tinytronix/homeautomation/Hardware/readme.md

Home automation hardware modules.
For all modules the gerber files are available.
The gerber files are proven in use and can be uploaded "as is" to any pcb manufacturer<br>

### The DIN rail housings (auf deutsch: Hutschienengehäuse) are available here:
https://www.reichelt.de/leergehaeuse-71-x-105-x-90-mm-6-te-hut-6-c-p44868.html<br>
https://www.reichelt.de/leergehaeuse-71-x-71-x-90-mm-4-te-hut-4-c-p44867.html?&trstct=pos_0<br>
OEM: https://www.h-tronic.de <br>

### Connector clamps:
AKL 073-03 Fahrstuhlklemme, 3-pol<br>
AKL 073-02 Fahrstuhlklemme, 2-pol<br>
https://www.reichelt.de<br>

### Other parts
see [part list](https://github.com/tinytronix/homeautomation/blob/master/Hardware/partlist.csv)
