tinytronix/homeautomation/Photos/readme.md

Controller Module:
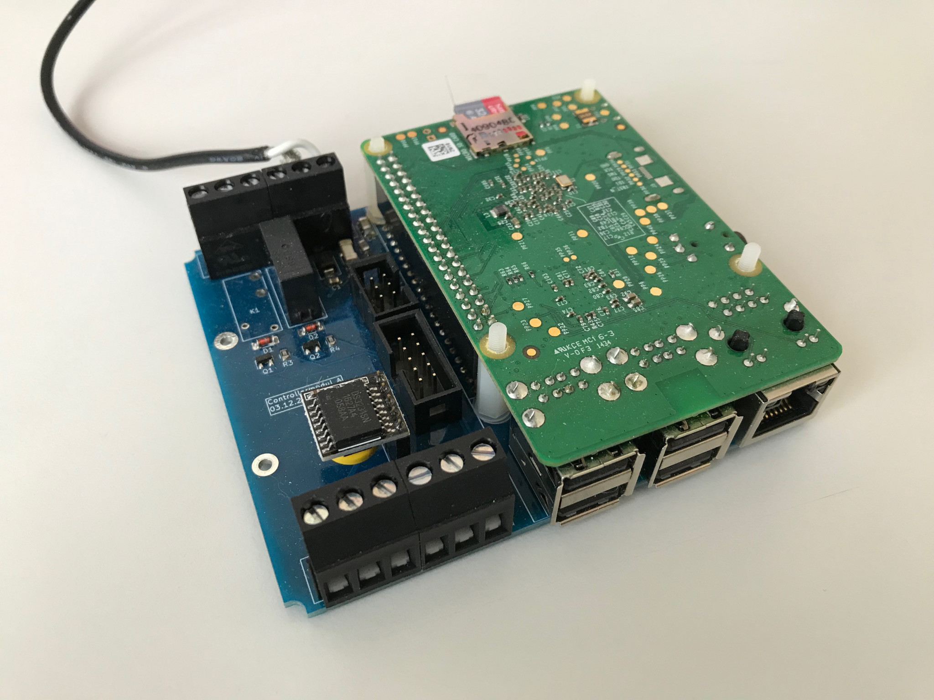
[picture p3: Photos/Controller_TypA.JPG]

<br>Modules open:
lt
<br>ESP07 (ESP8266) Controller Module:
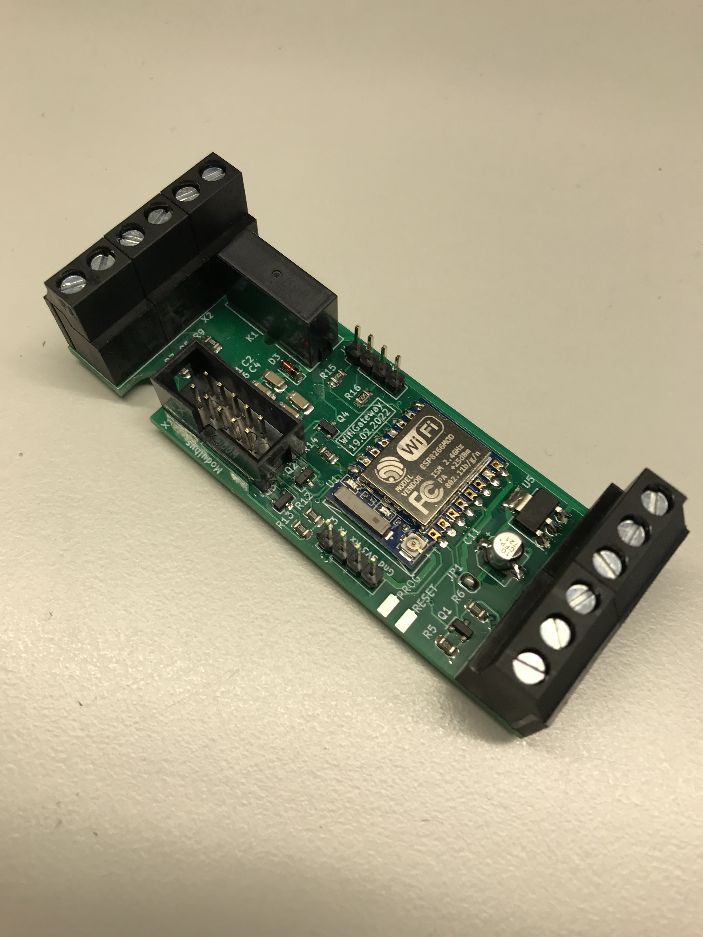
[picture p4: Photos/ESP07.jpg]

<br>ATMega328 Controller Module with ethernet:
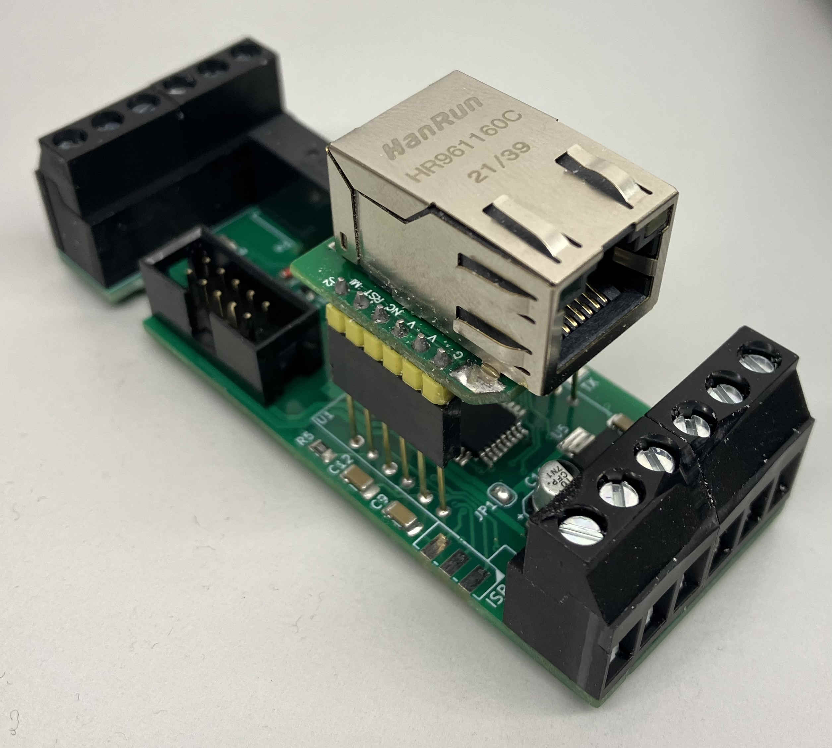
[picture p5: Photos/ControllerC1.jpg]

<br>ATMega328 Controller Module with ethernet with housing:
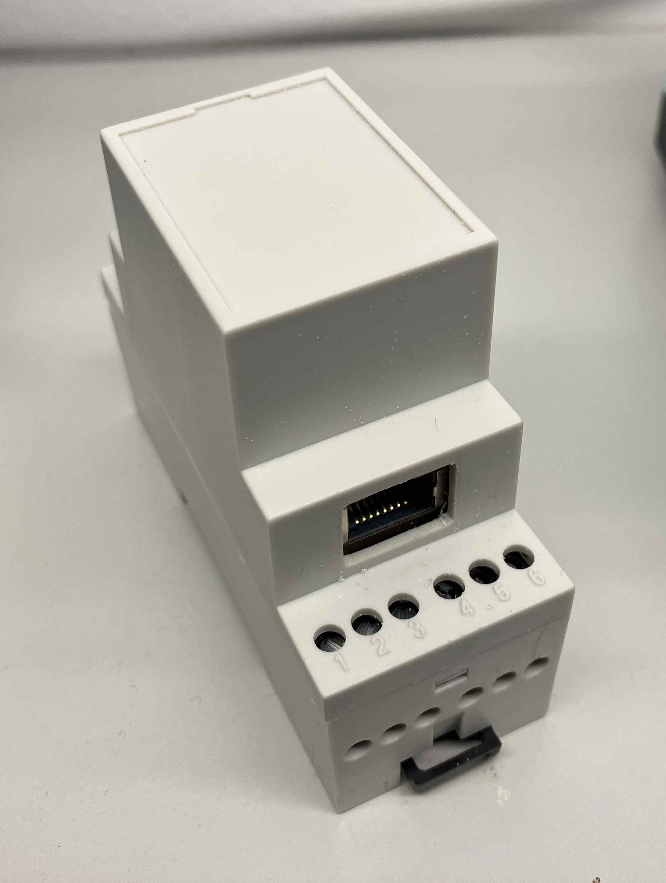
[picture p6: Photos/ControllerC3.jpg]

<br>Analog module:
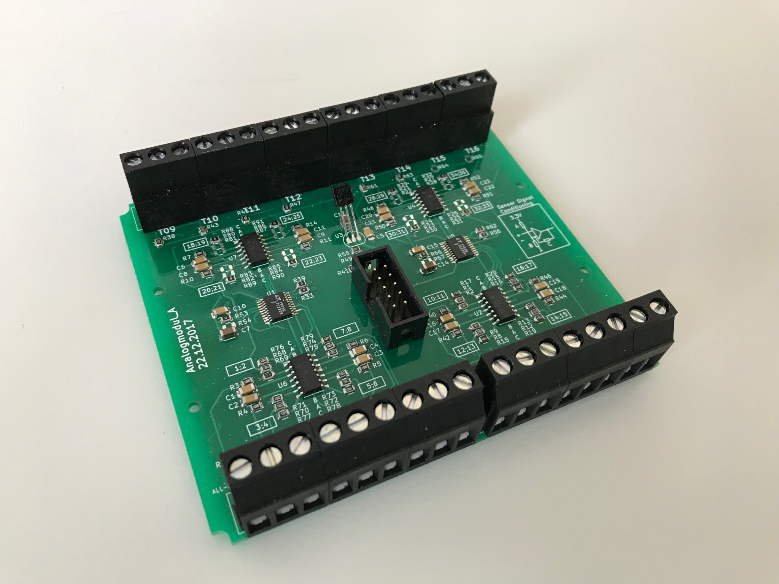
[picture p7: Photos/Analogmodul_TypA.JPG]

<br>Switching module Type A
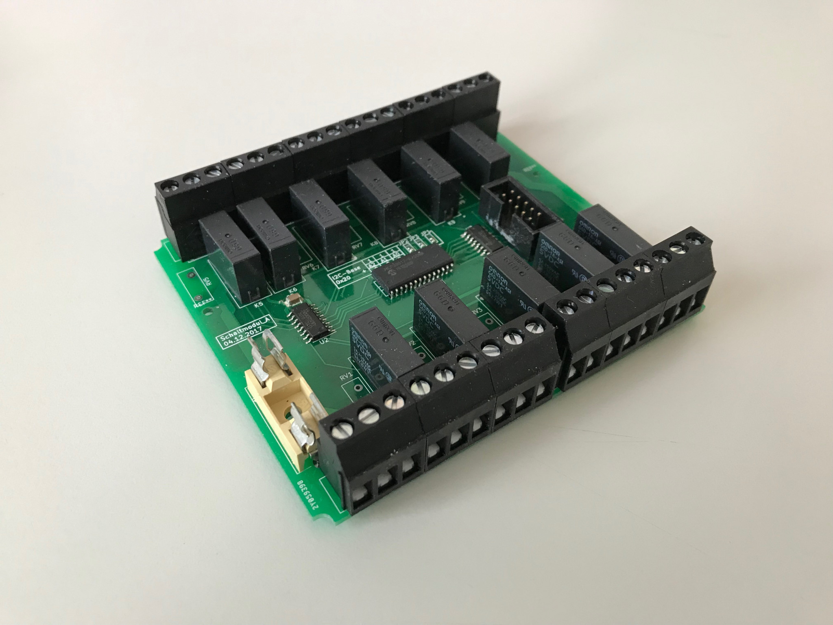
[picture p8: Photos/Schaltmodul_A.JPG]

<br>Inwall LoRa shutter module top view
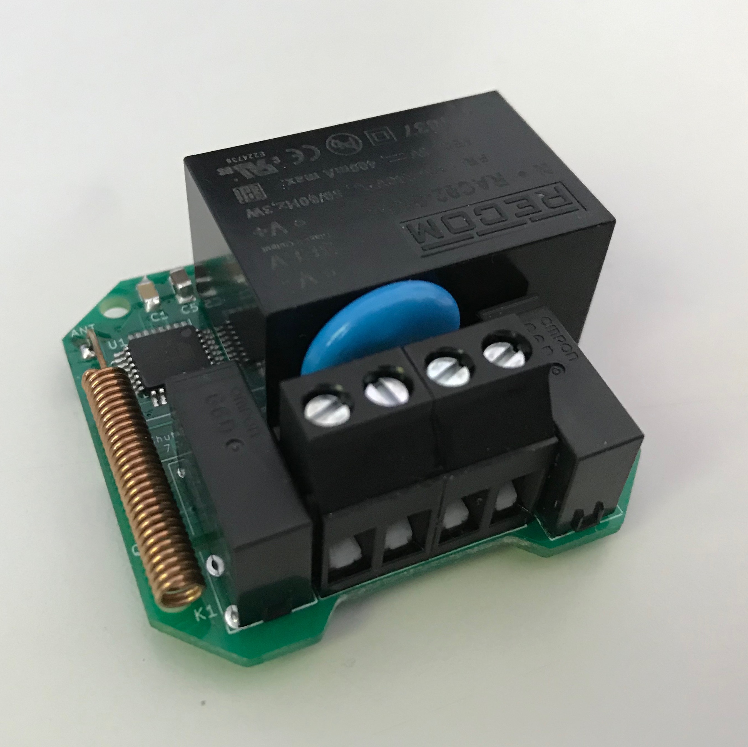
[picture p9: Photos/loraShutterModuleTop.JPG]

<br>Inwall LoRa shutter module bottom view
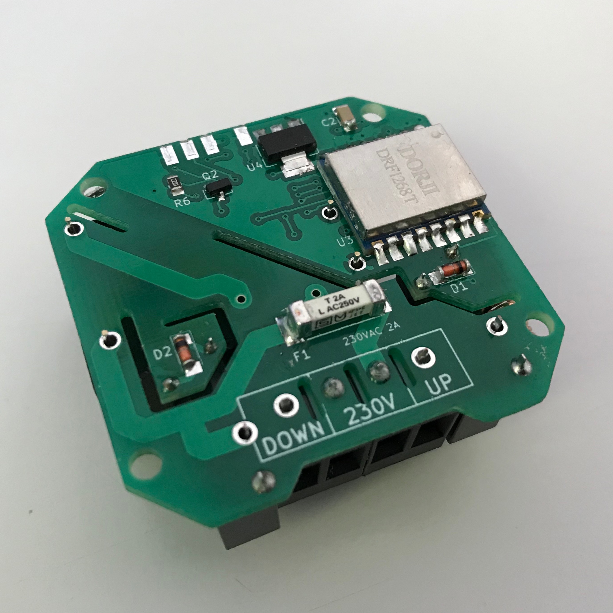
[picture p10: Photos/loraShutterModuleBottom.JPG]

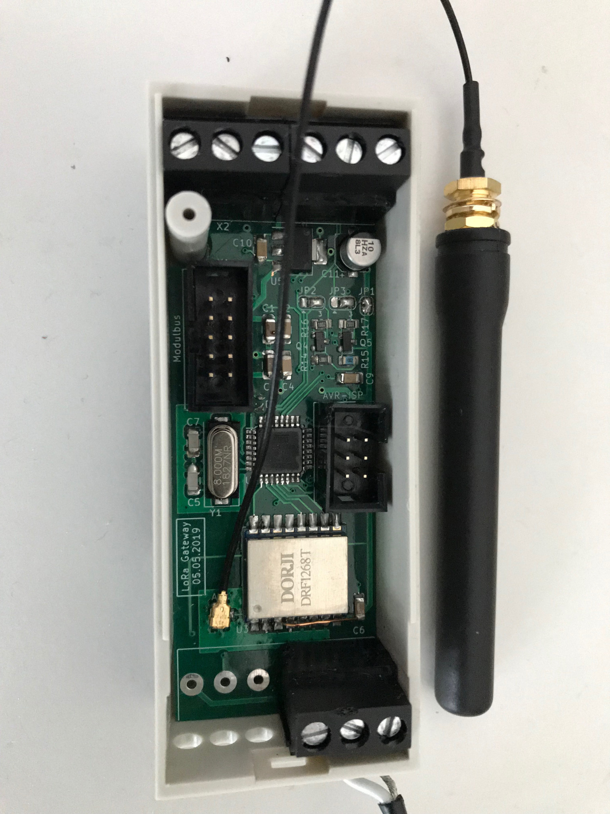
[picture p11: Photos/LoRa2.JPG]

<br>LoRa Wall plug
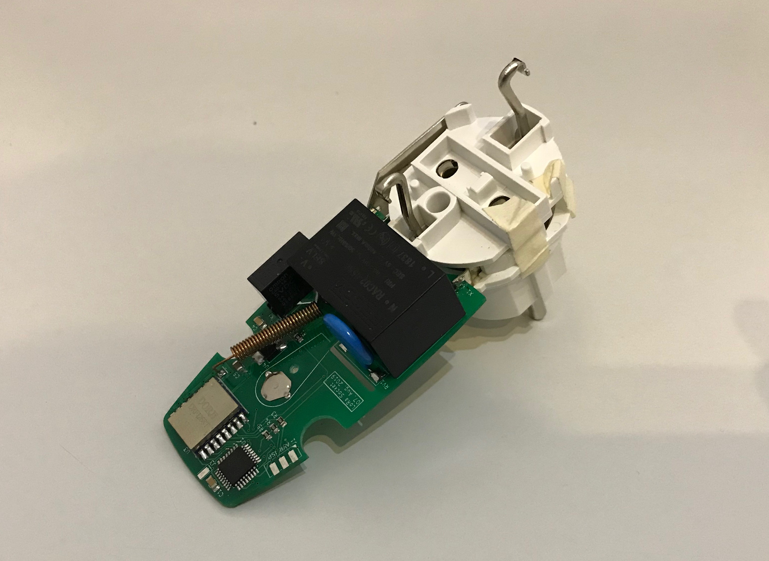
[picture p12: Photos/loraSteckdoseInnen.JPG]

<br>LoRa Wall plug mounted
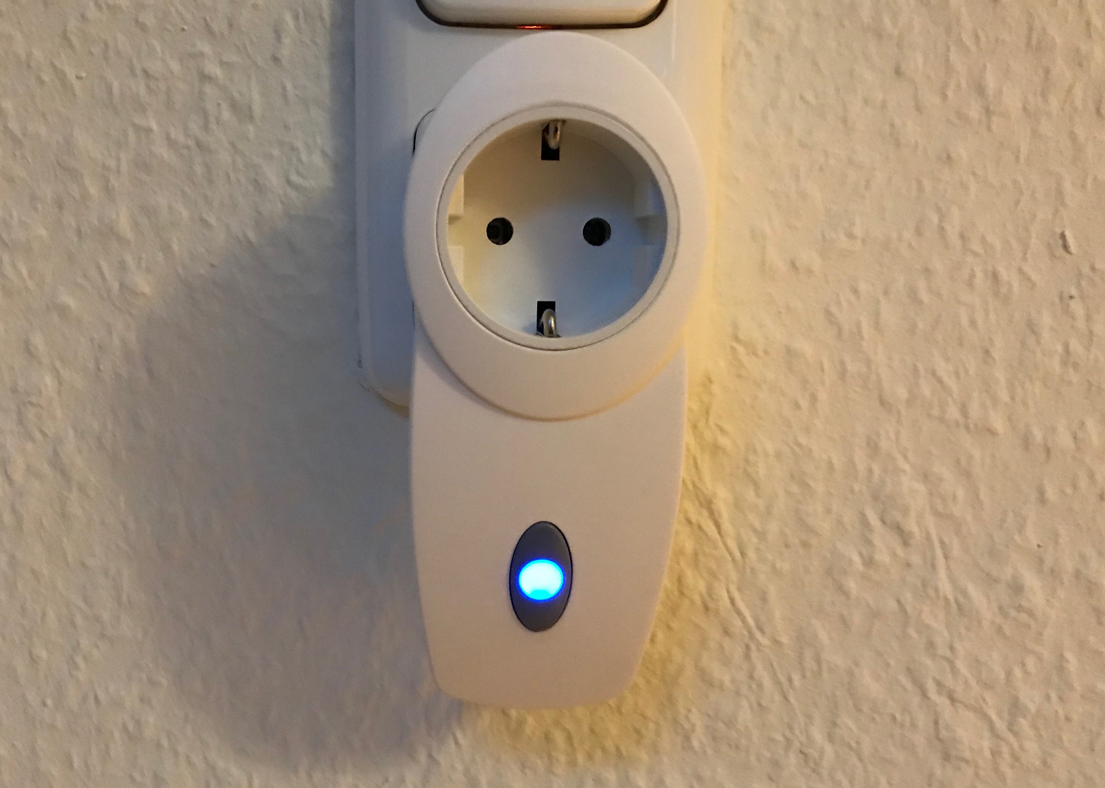
[picture p13: Photos/loraSteckdose.JPG]

<br>I2C Module Bus connector
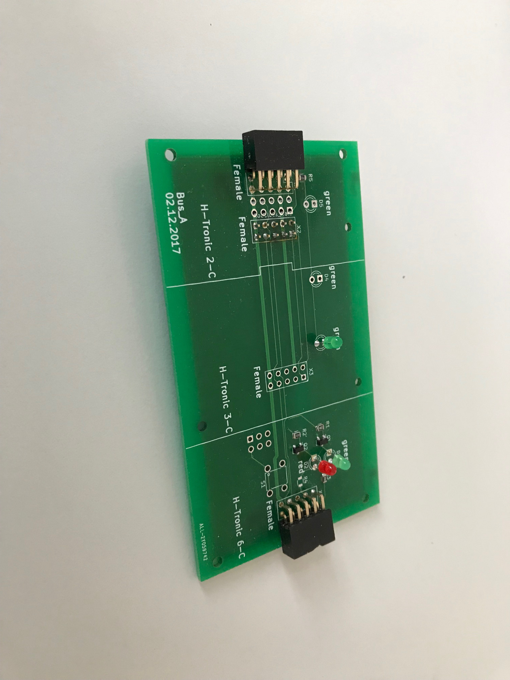
[picture p14: Photos/I2CBus.JPG]

<br>I2C Module Bus connector
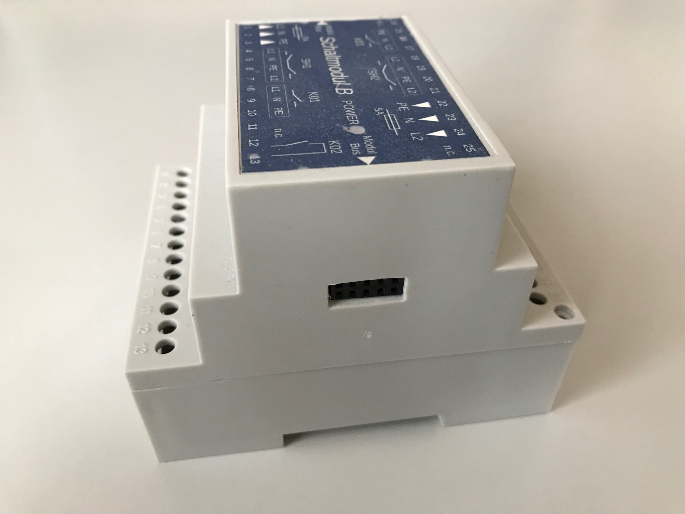
[picture p15: Photos/I2CConnector.JPG]
