tinytronix/homeautomation/Photos/README.md

lt

Analogmodul Typ A:
lt

Controller with Raspberry:
lt

Digital input Module Typ A for mains detection:
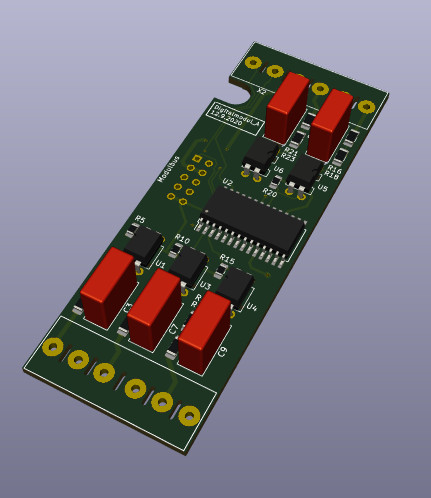
[picture p16: Photos/Digitalmodul_A.JPG]


LoRa Gateway or Bridge Module
lt

Switching Module Typ A
lt

LoRa Inwall SHutter Module
lt

LoRa switched Power Outlet
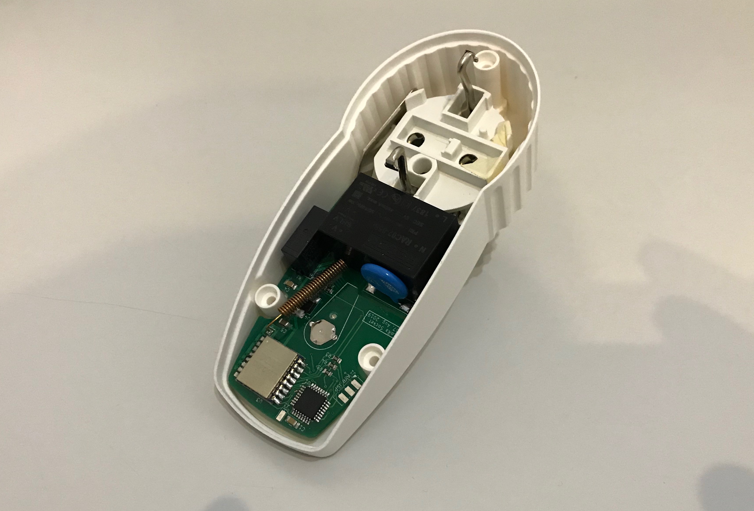
[picture p17: Photos/loraSteckdoseUnterteil.JPG]
