tinytronix/homeautomation/Hardware/Schaltmodul_C/readme.md

This module is a derivate of Schaltmodul_A and Schaltmodul_B.
It is optimised for garden irrigation purposes and can switch 16 channels.
