tinytronix/homeautomation/Hardware/Digitalmodul_A/readme.md

This module can read mains status (5 channels) and has one logic counter input 5V logic level.
