tinytronix/homeautomation/Hardware/LoraPowerswitch/readme.md

This LoRa node module is for switching 230V/2A on/off. 

Parameters:
- DRF1268 LoRa Module
- ATMega328 with internal 8MHz oscillator
- fits in a standard housing which can be sourced from [ELV Artnr. 68-08 34 21](https://www.elv.de/elv-design-stecker-steckdosen-gehaeuse-om-54-c-mit-tasterstoessel-und-led-leuchtfeld.html) 
- Atmel ISP interface and a serial tx connector at the pcb edge
- requires bootloader as explained here: https://www.arduino.cc/en/Tutorial/ArduinoToBreadboard
- remote controlled by the [Lora Gateway](https://github.com/tinytronix/homeautomation/tree/master/Hardware/LoraGateway)

Complete device:
lt
open:
lt
PCB only:
lt
