tinytronix/homeautomation/Hardware/LoraInwallShutter/readme.md

This LoRa node module is for driving window shutters or window blinds. (pulse up and pulse down). It can as well be used for switching lights or wall power outlets (permanent on/off).<br>
Parameters:
- DRF1268 LoRa Module
- ATMega328 with internal 8MHz oscillator
- fits in a 57mm diameter inwall housing <br>
- Height is 22mm
- extra deep inwall housings needed when placed behind wall switch/wall power outlet
- Atmel ISP interface and 
- a serial tx connector at the pcb edge.
- requires bootloader as explained here: https://www.arduino.cc/en/Tutorial/ArduinoToBreadboard
- remote controlled by the [Lora Gateway](https://github.com/tinytronix/homeautomation/tree/master/Hardware/LoraGateway)

Top view:
lt
Bottom view:
lt
