tinytronix/homeautomation/Hardware/Schaltmodul_A/readme.md

This module contains 11 Relais, 230V AC, 5A
