tinytronix/homeautomation/Hardware/Analogmodul_A/readme.md

This module contains 16 Analog inputs with 16 Rail-2-Rail OP-Amps for signal conditioning. 
The module can be connected to a controller module which reads the analog inputs.
