tinytronix/homeautomation/Photos/ControllerC2.jpg

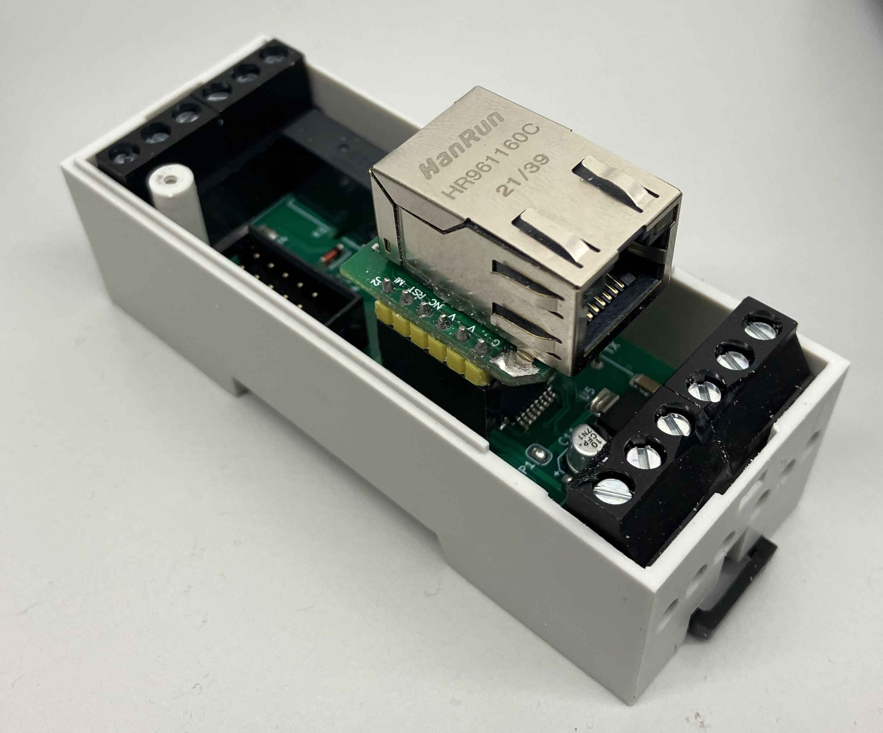
Photos/ControllerC2.jpg
