tinytronix/homeautomation/Photos/LoRa1.JPG

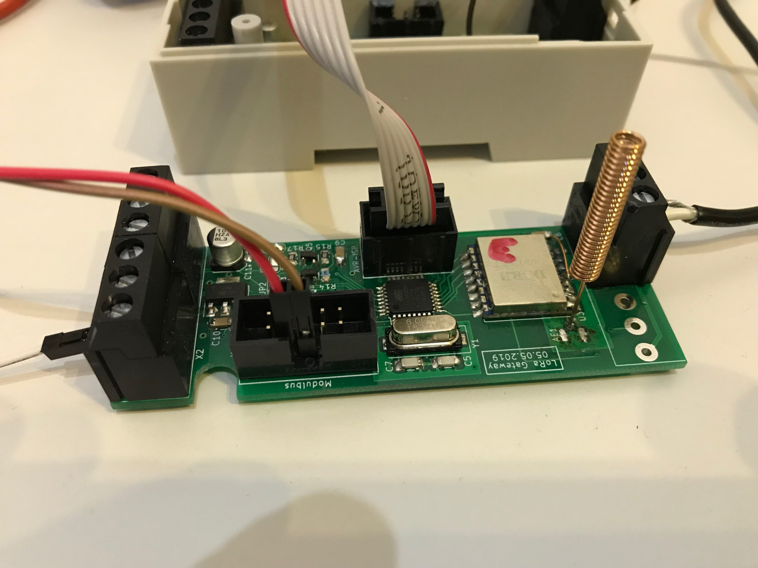
Photos/LoRa1.JPG
