tinytronix/homeautomation/Photos/LoraShutterMudule_3D.jpg

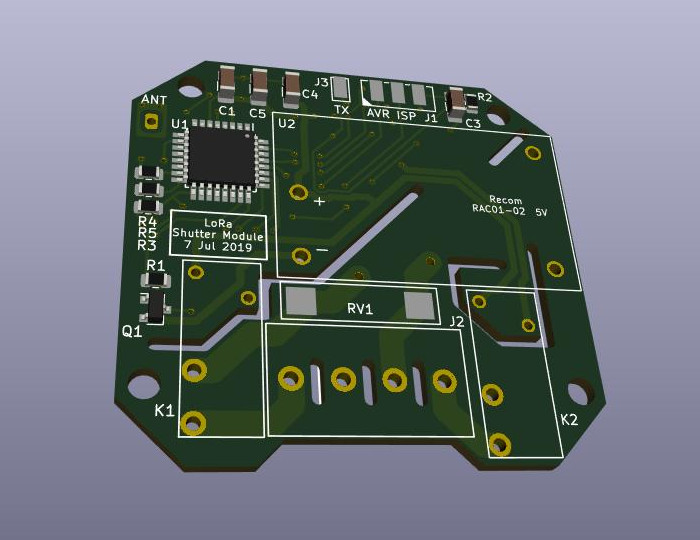
Photos/LoraShutterMudule_3D.jpg
