tinytronix/homeautomation/Hardware/Controllermodul_D/Schematic.pdf

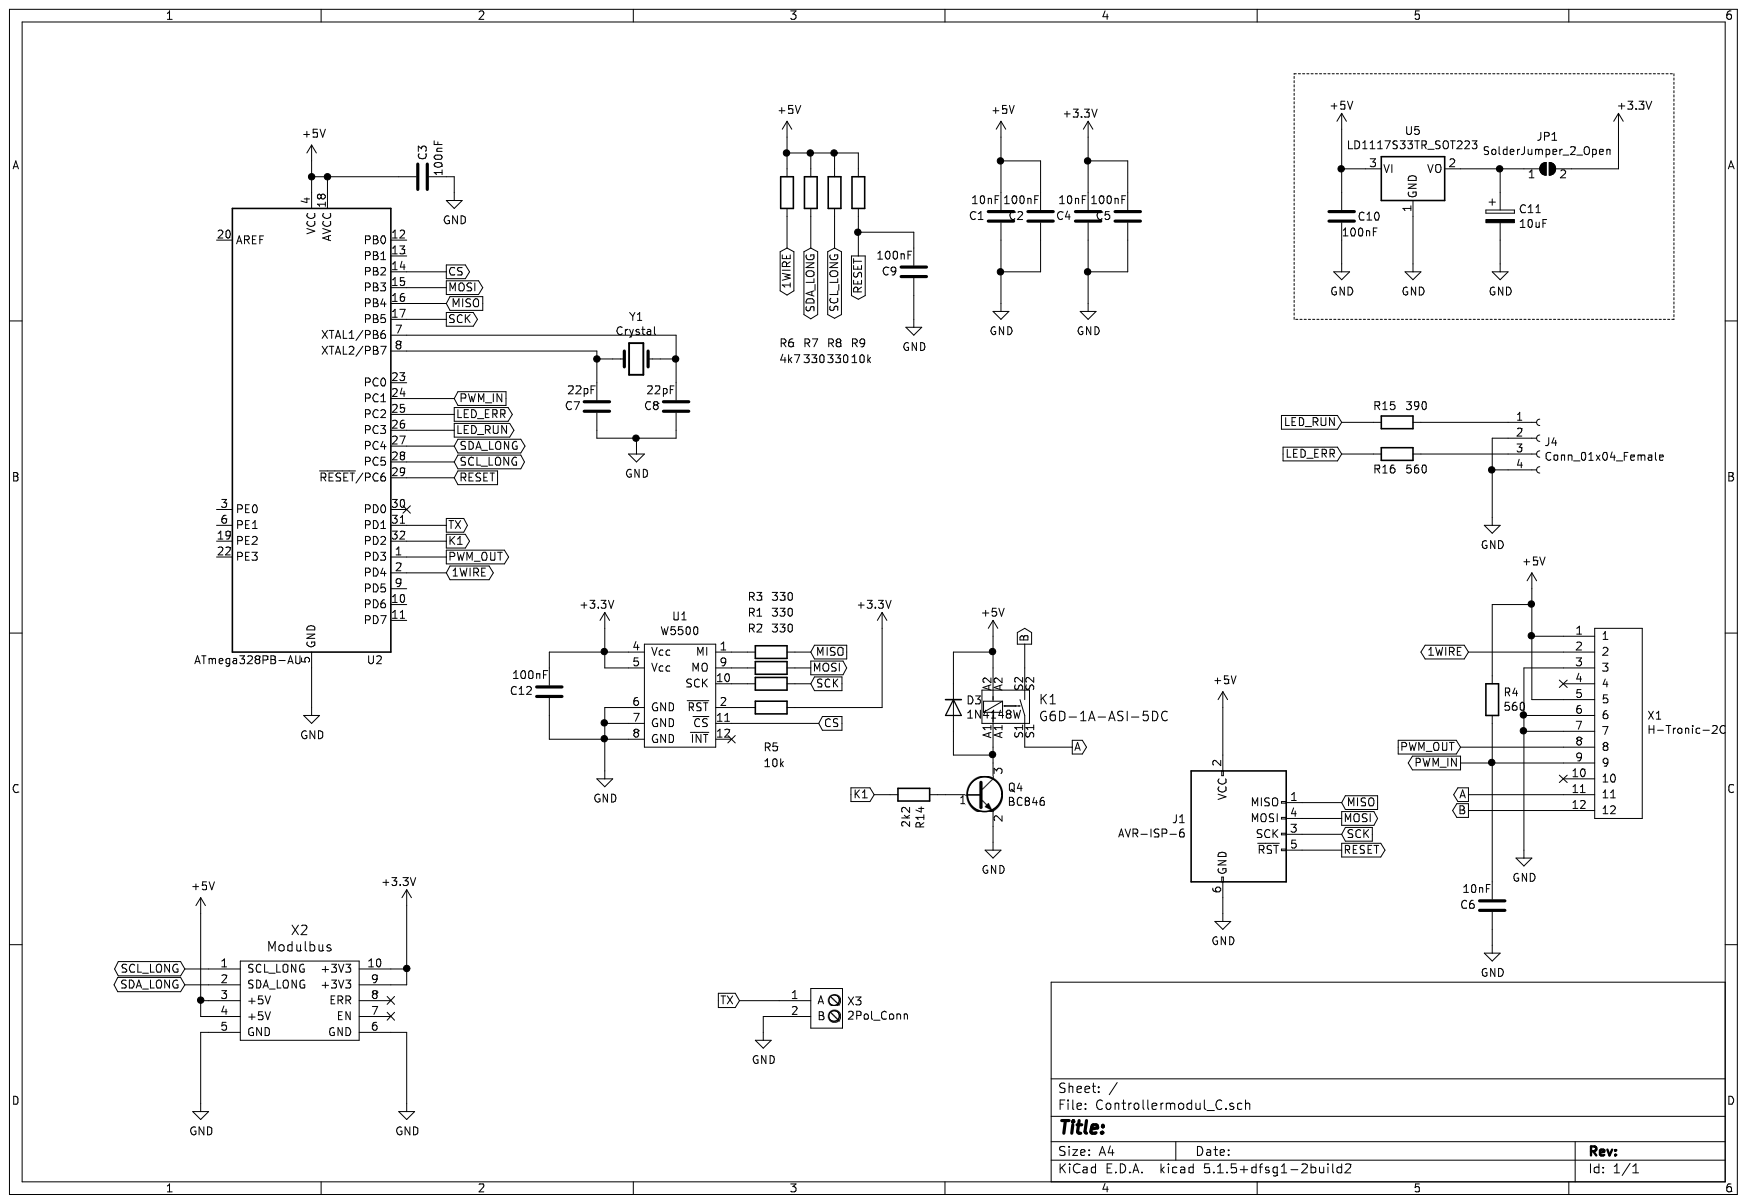
[picture p21: page 1]
