tinytronix/homeautomation/Hardware/Controllermodul_C/schematic.pdf

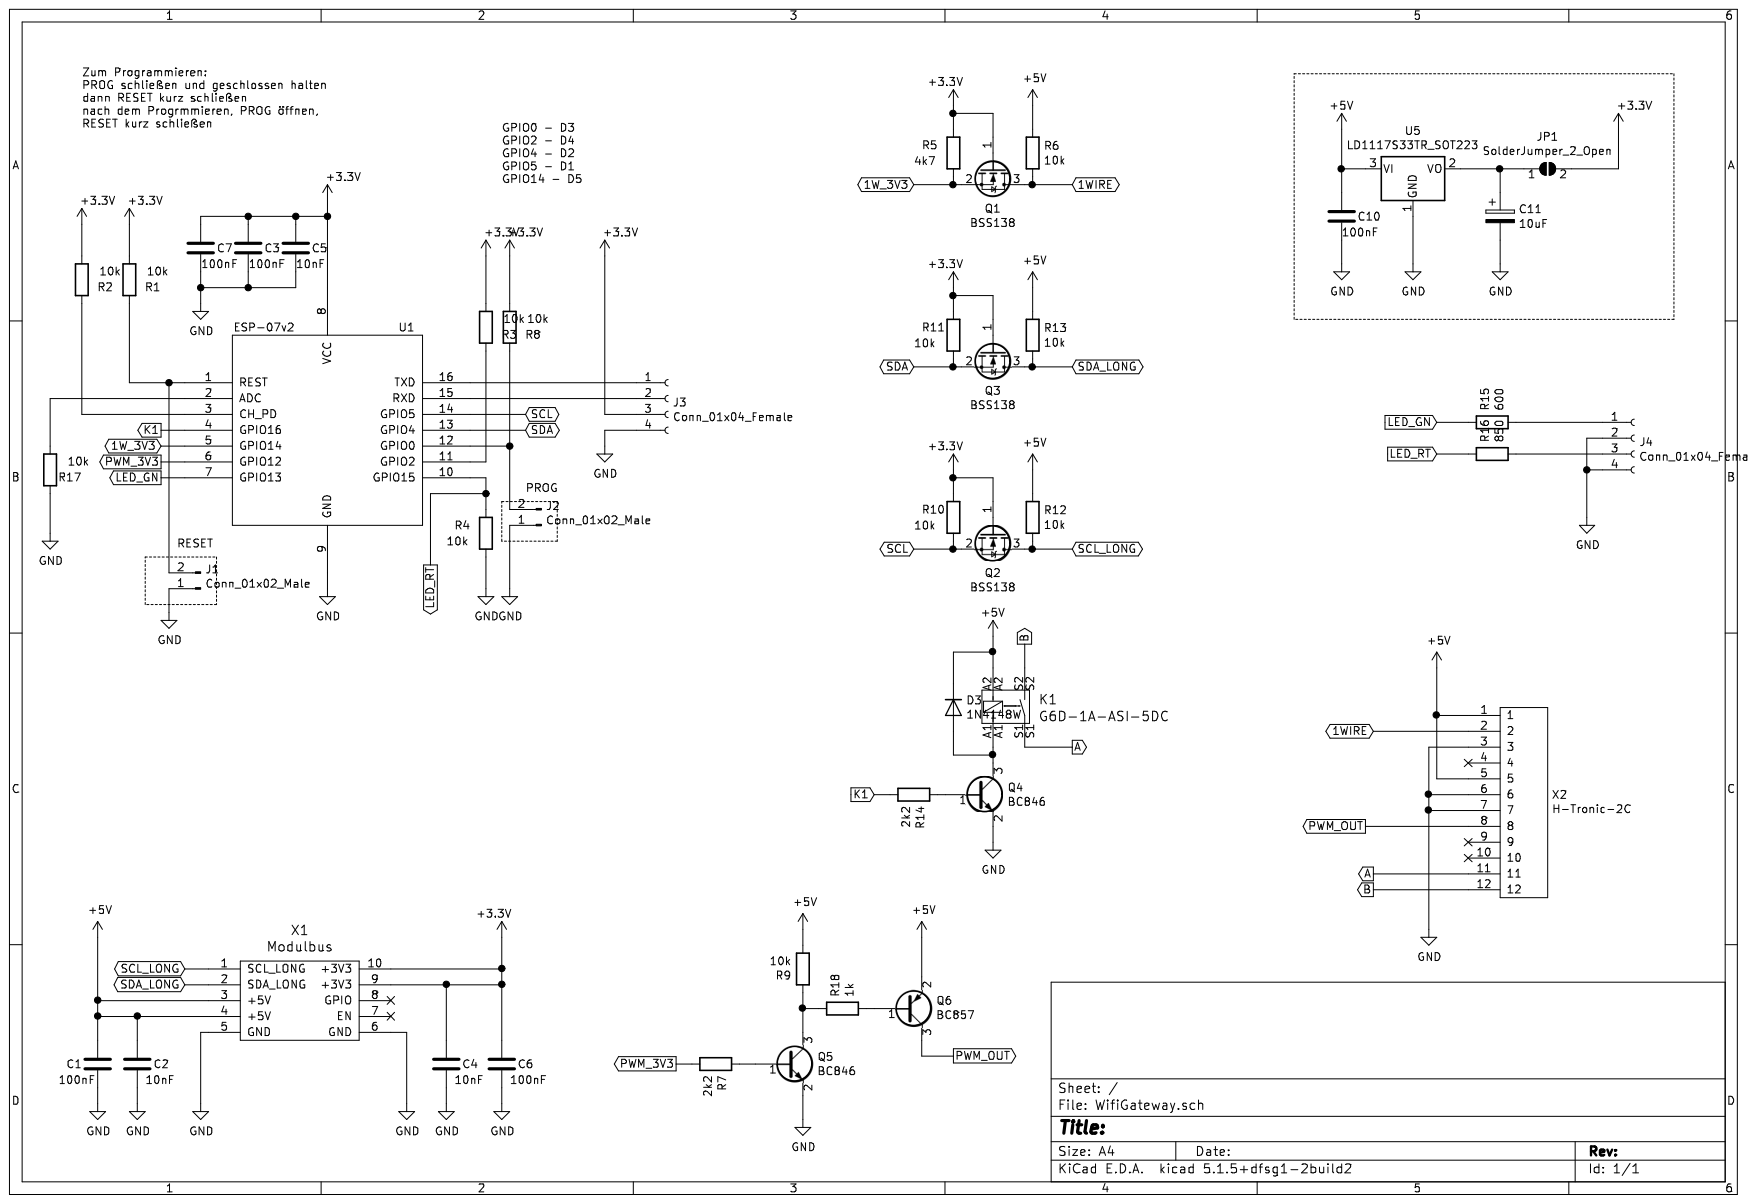
[picture p22: page 1]
