tinytronix/homeautomation/Hardware/Schaltmodul_C/Schematic.pdf

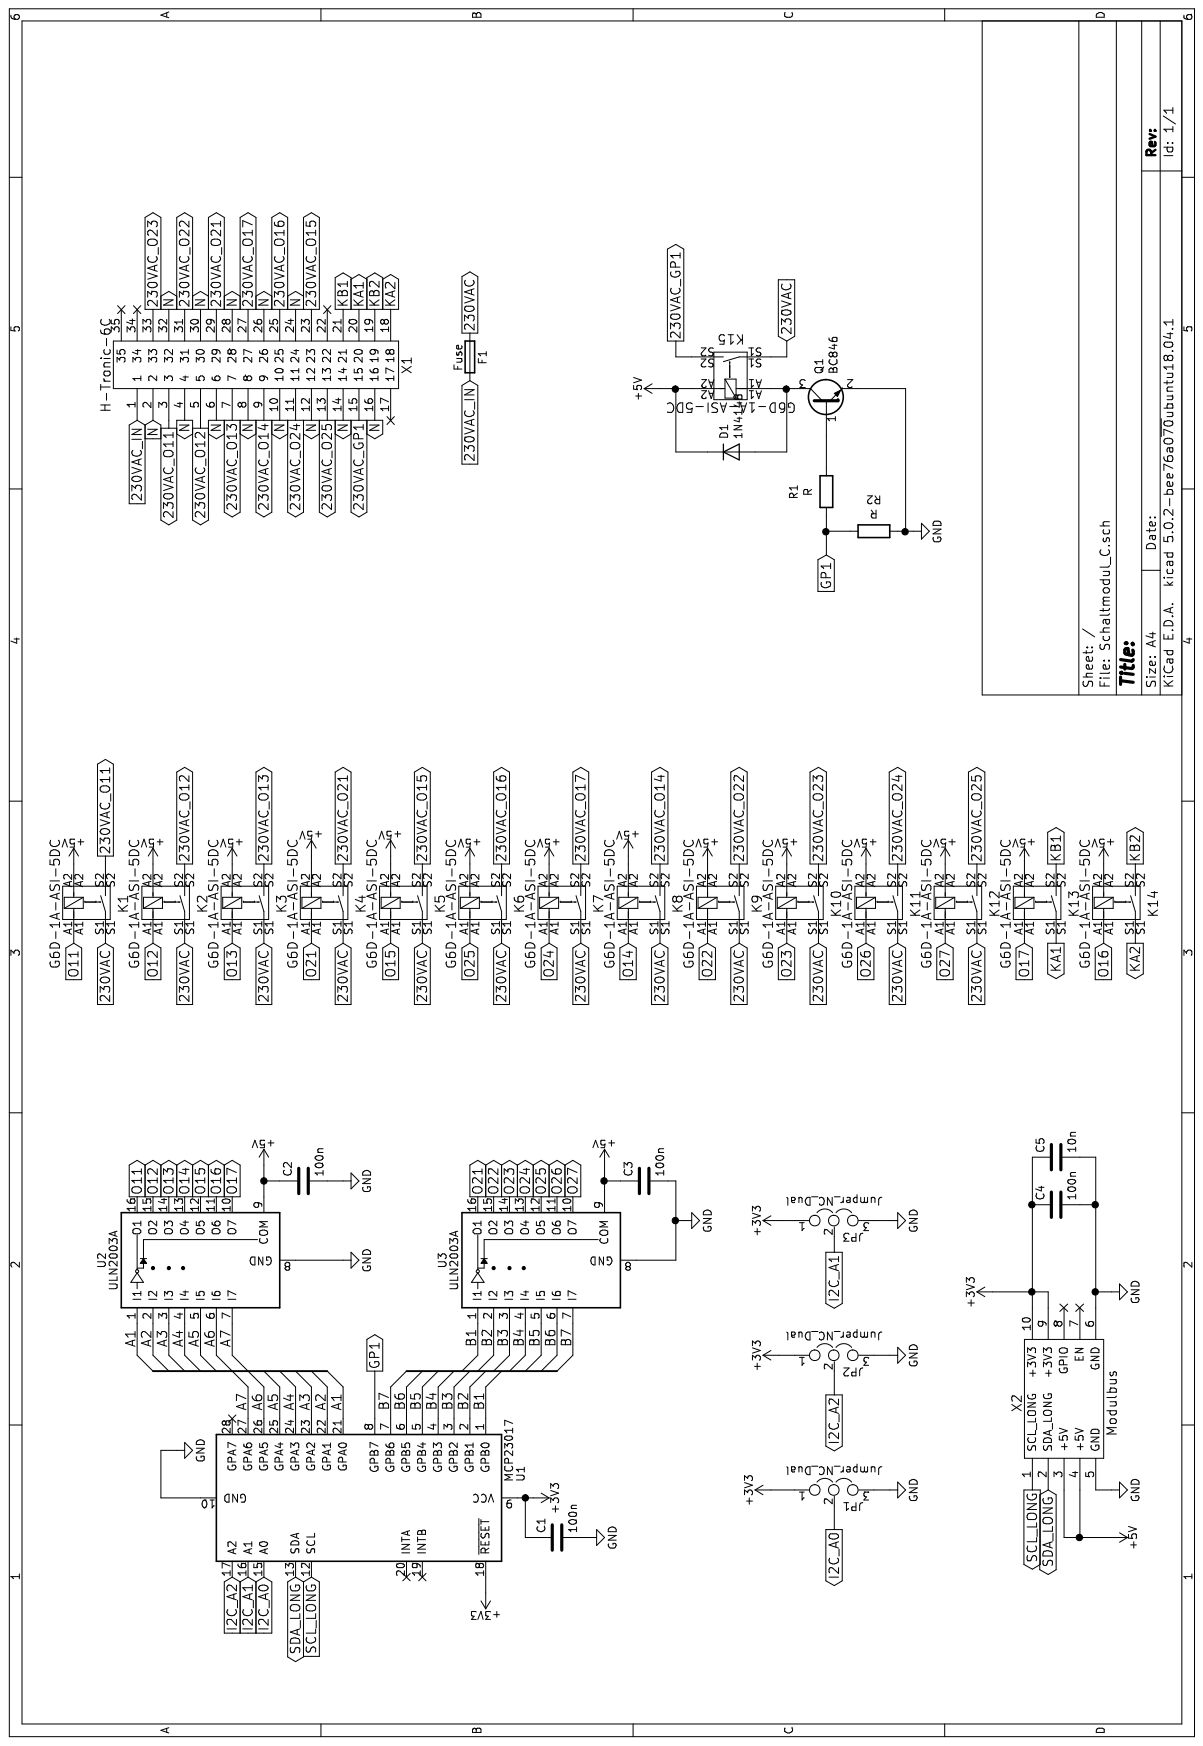
[picture p23: page 1]
