tinytronix/homeautomation/Hardware/Digitalmodul_A/Schematic.pdf

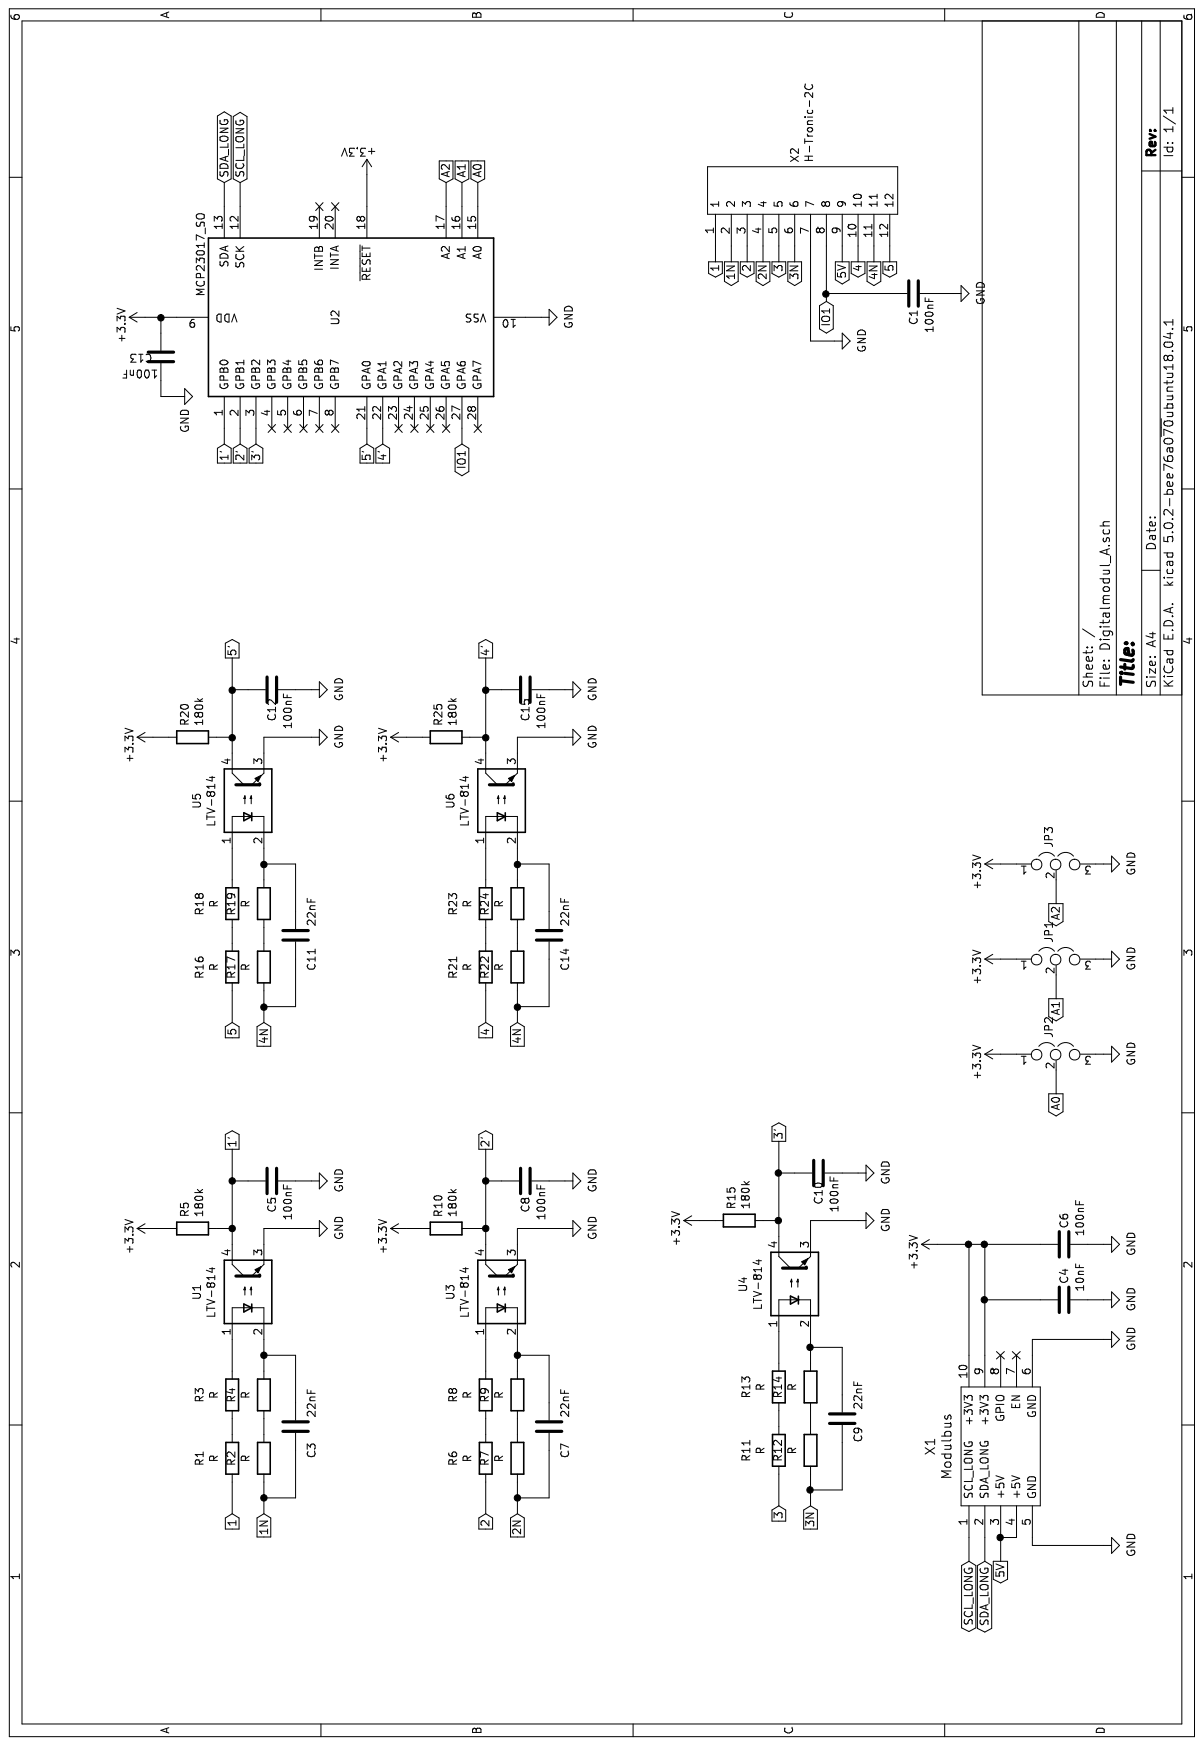
[picture p24: page 1]
