tinytronix/homeautomation/Hardware/Controllermodul_B/Schematic.pdf

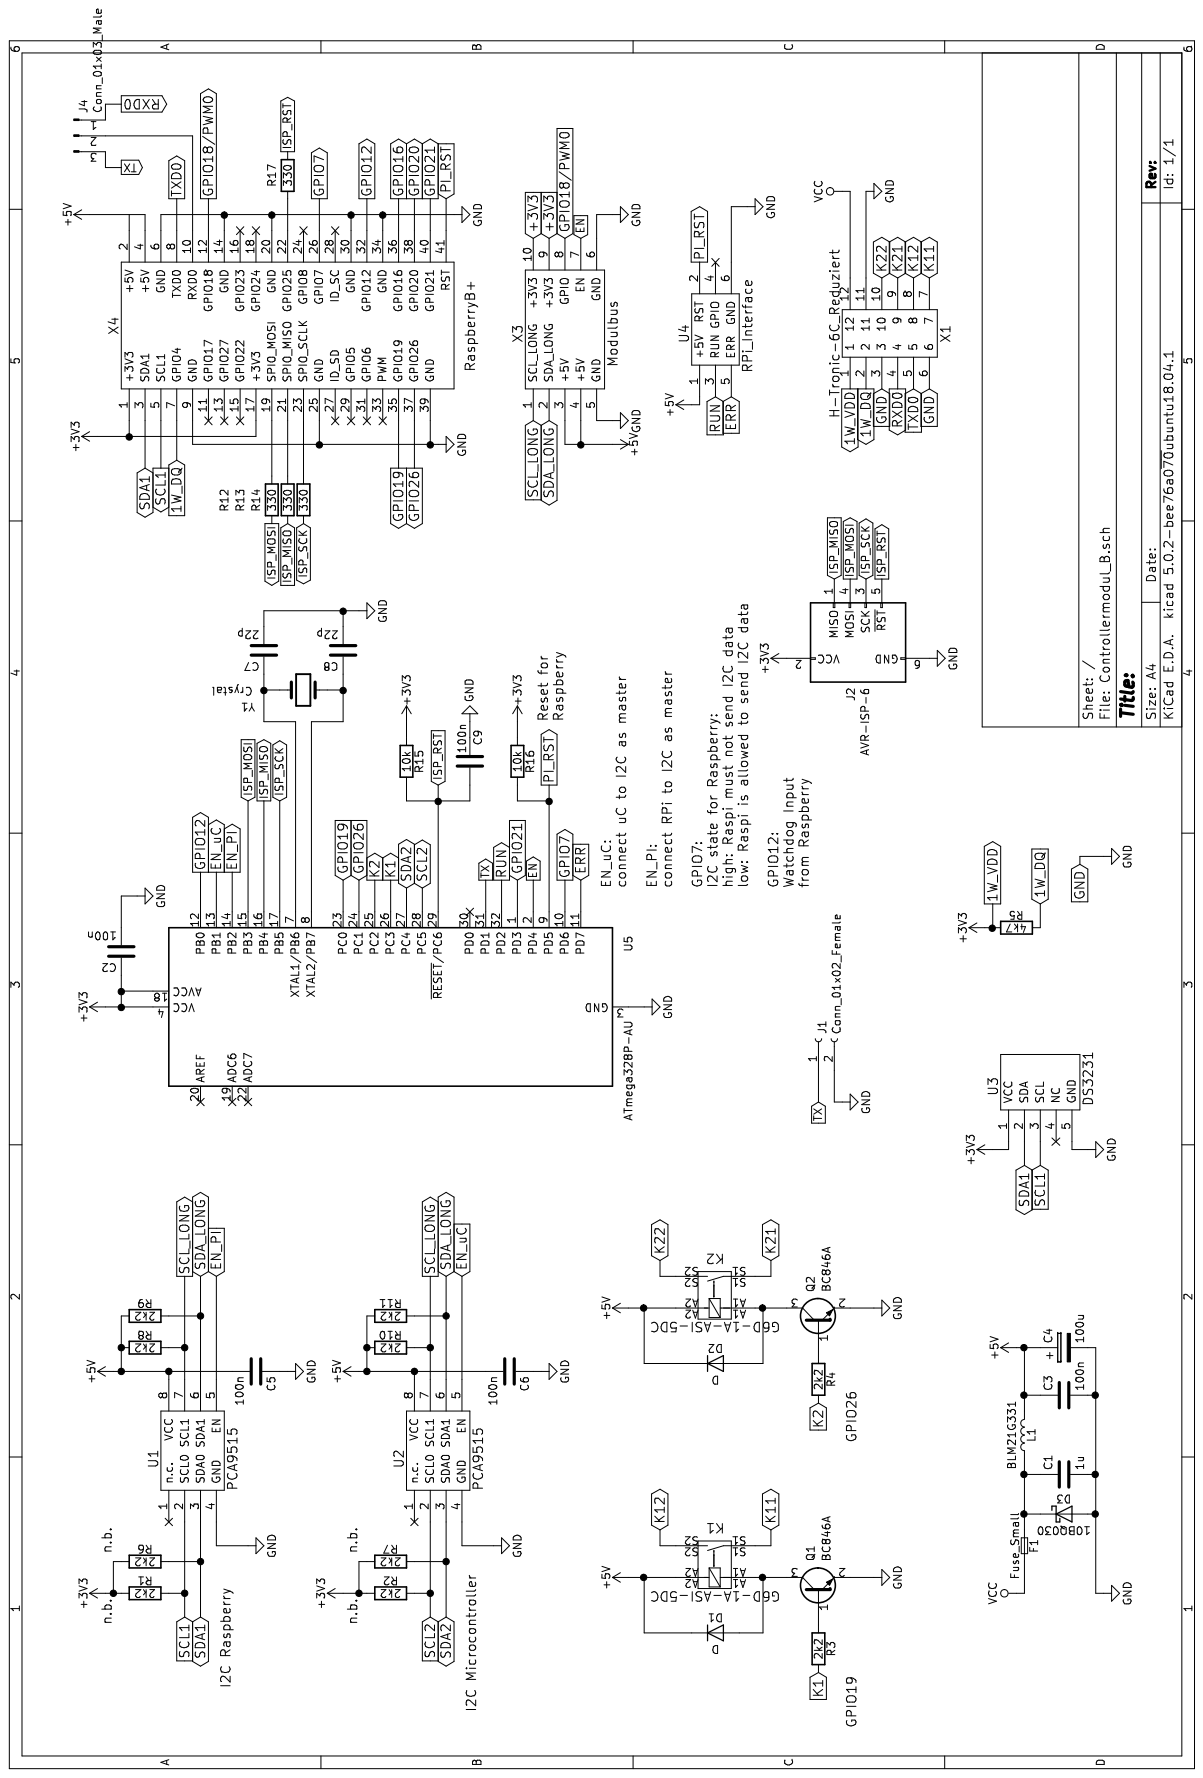
[picture p25: page 1]
