tinytronix/homeautomation/Hardware/LoraPowerswitch/schematic.pdf

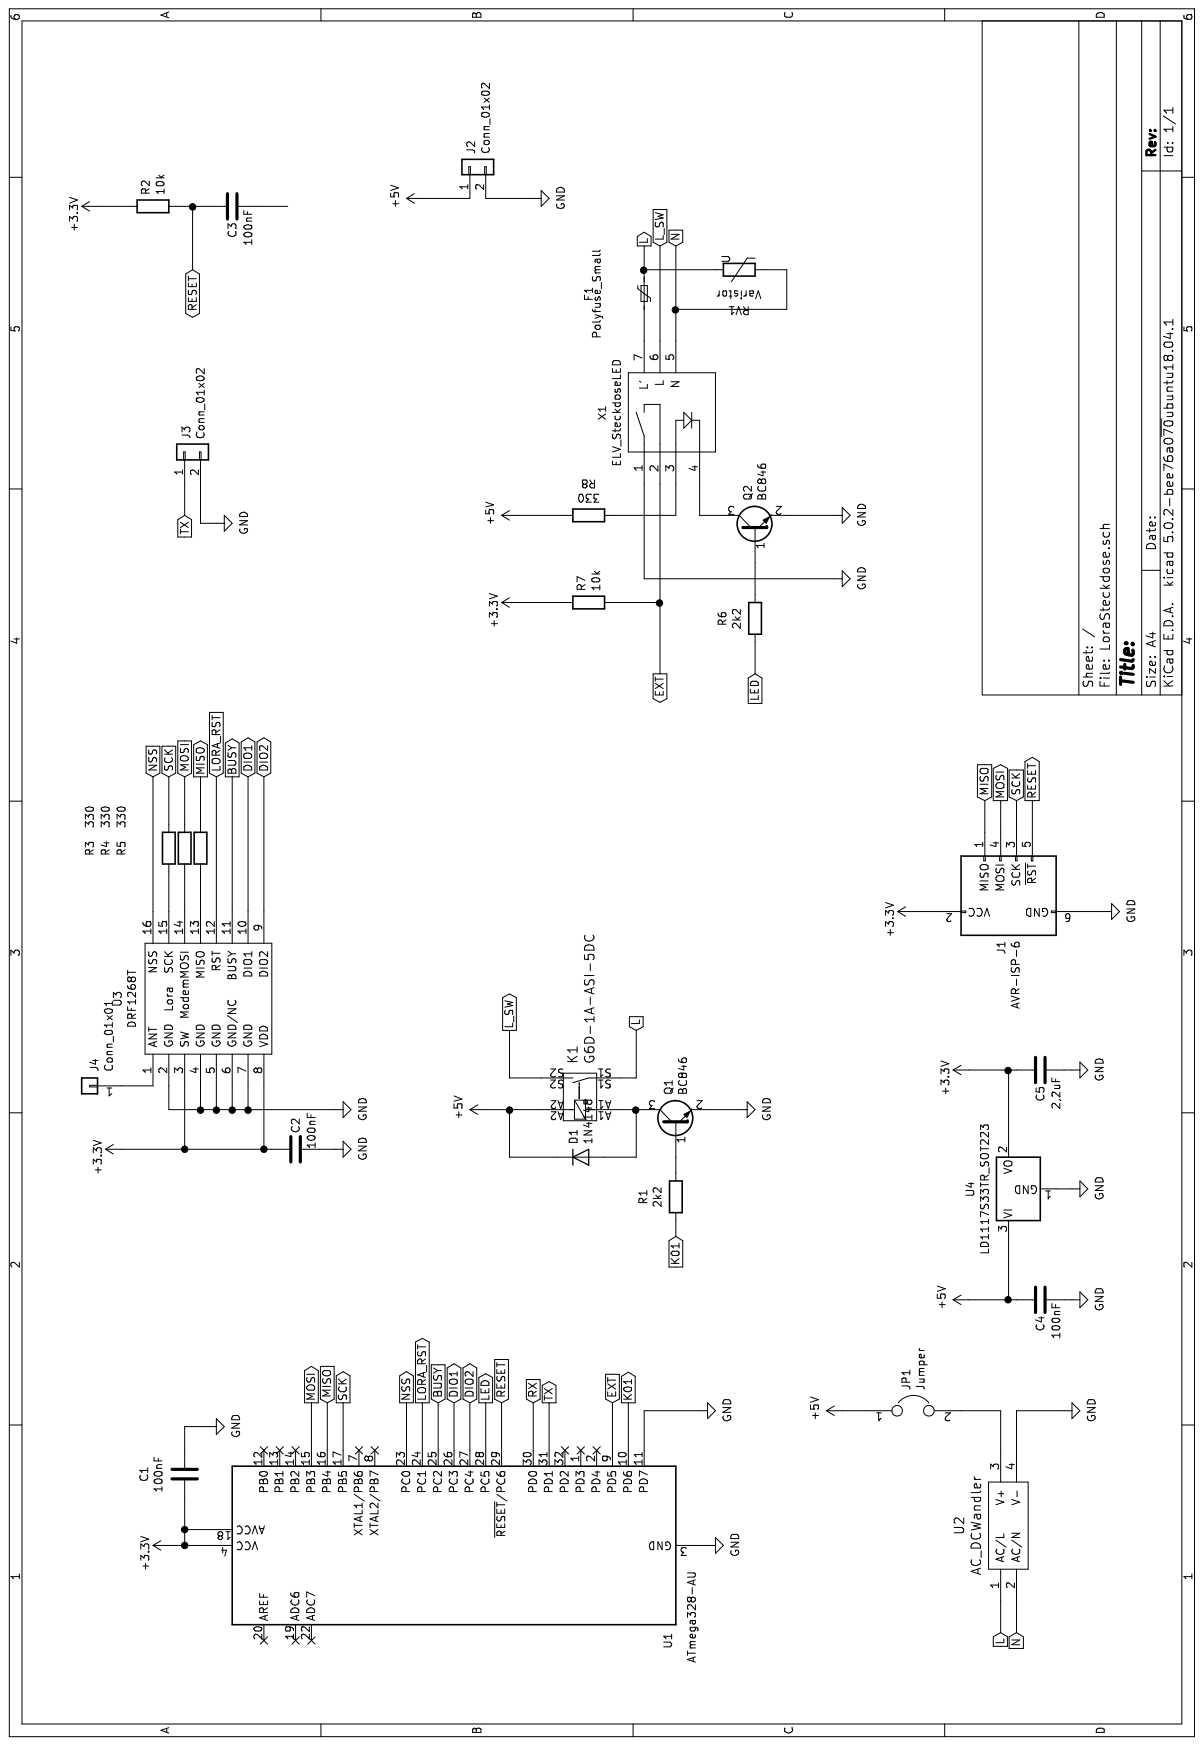
[picture p26: page 1]
