tinytronix/homeautomation/Hardware/LoraInwallShutter/Schematic.pdf

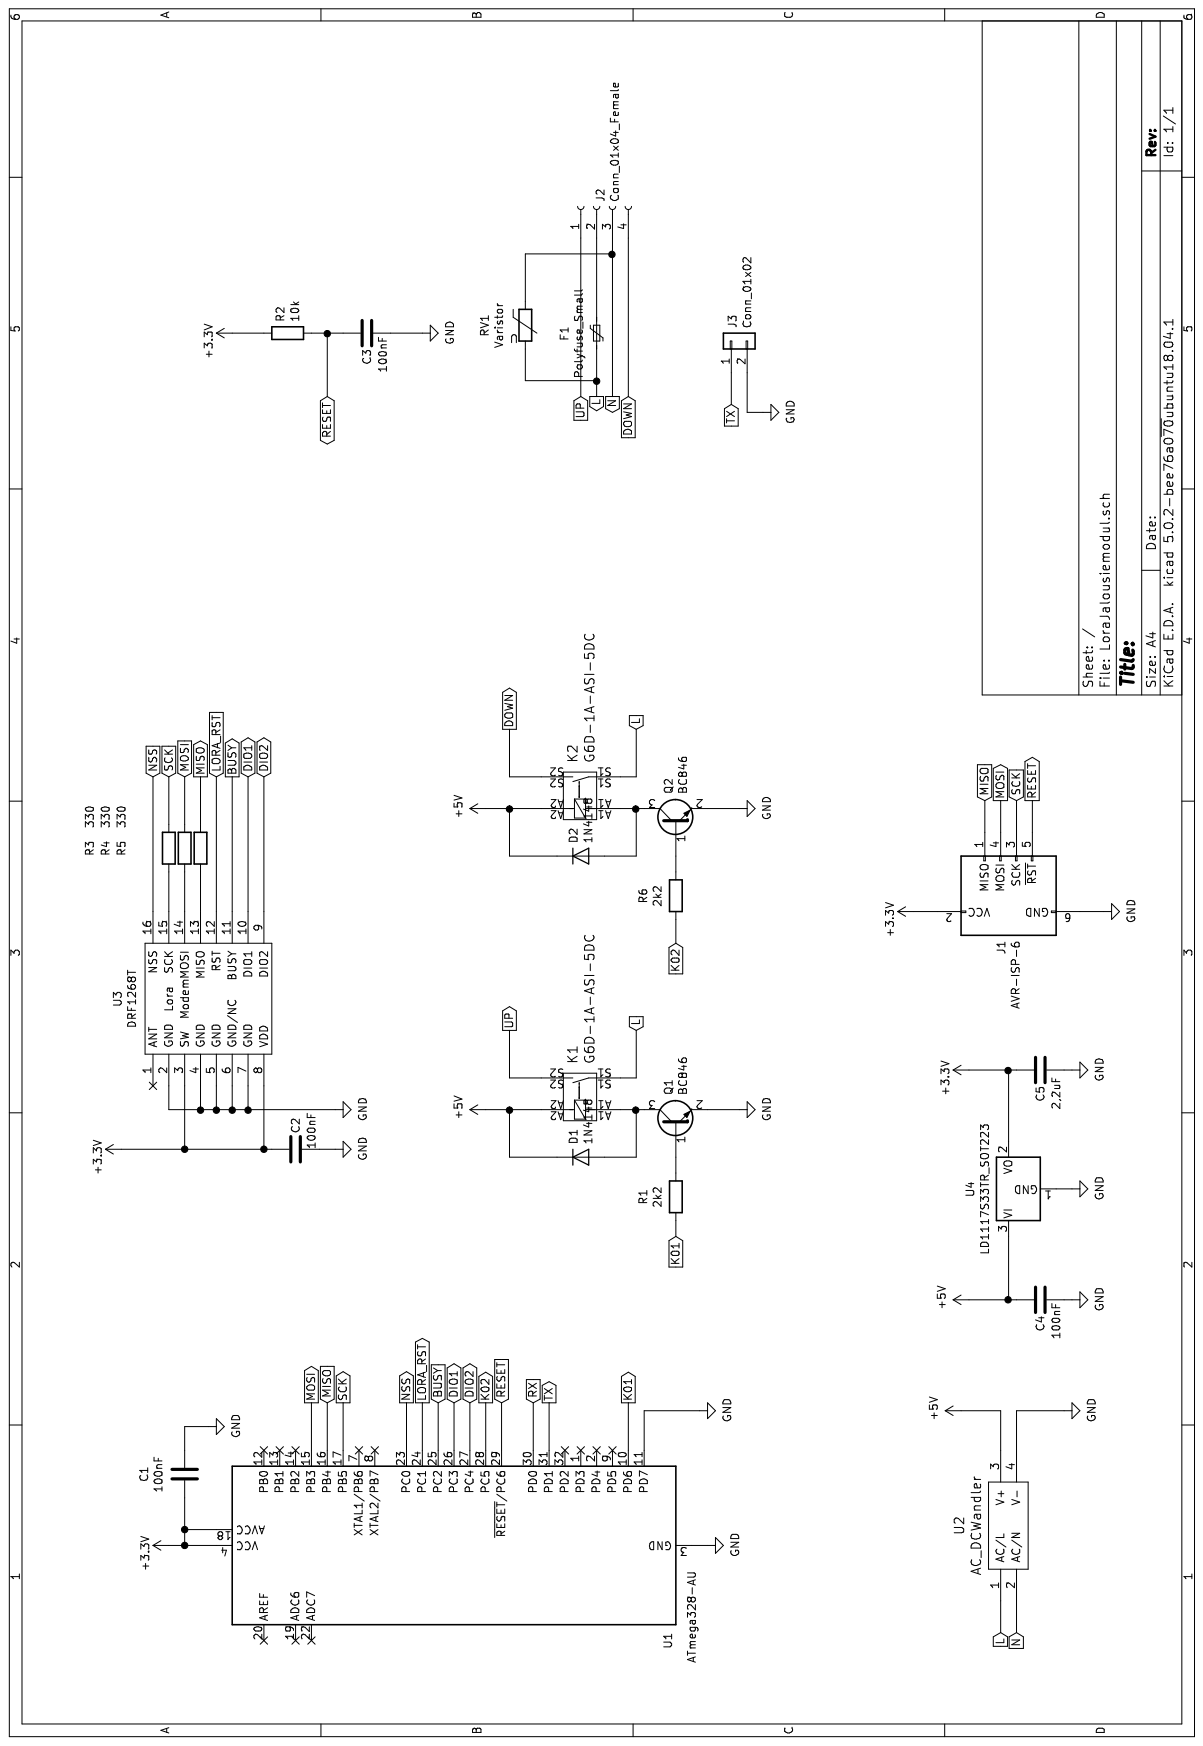
[picture p27: page 1]
