tinytronix/homeautomation/Hardware/LoraGateway/Schematic.pdf

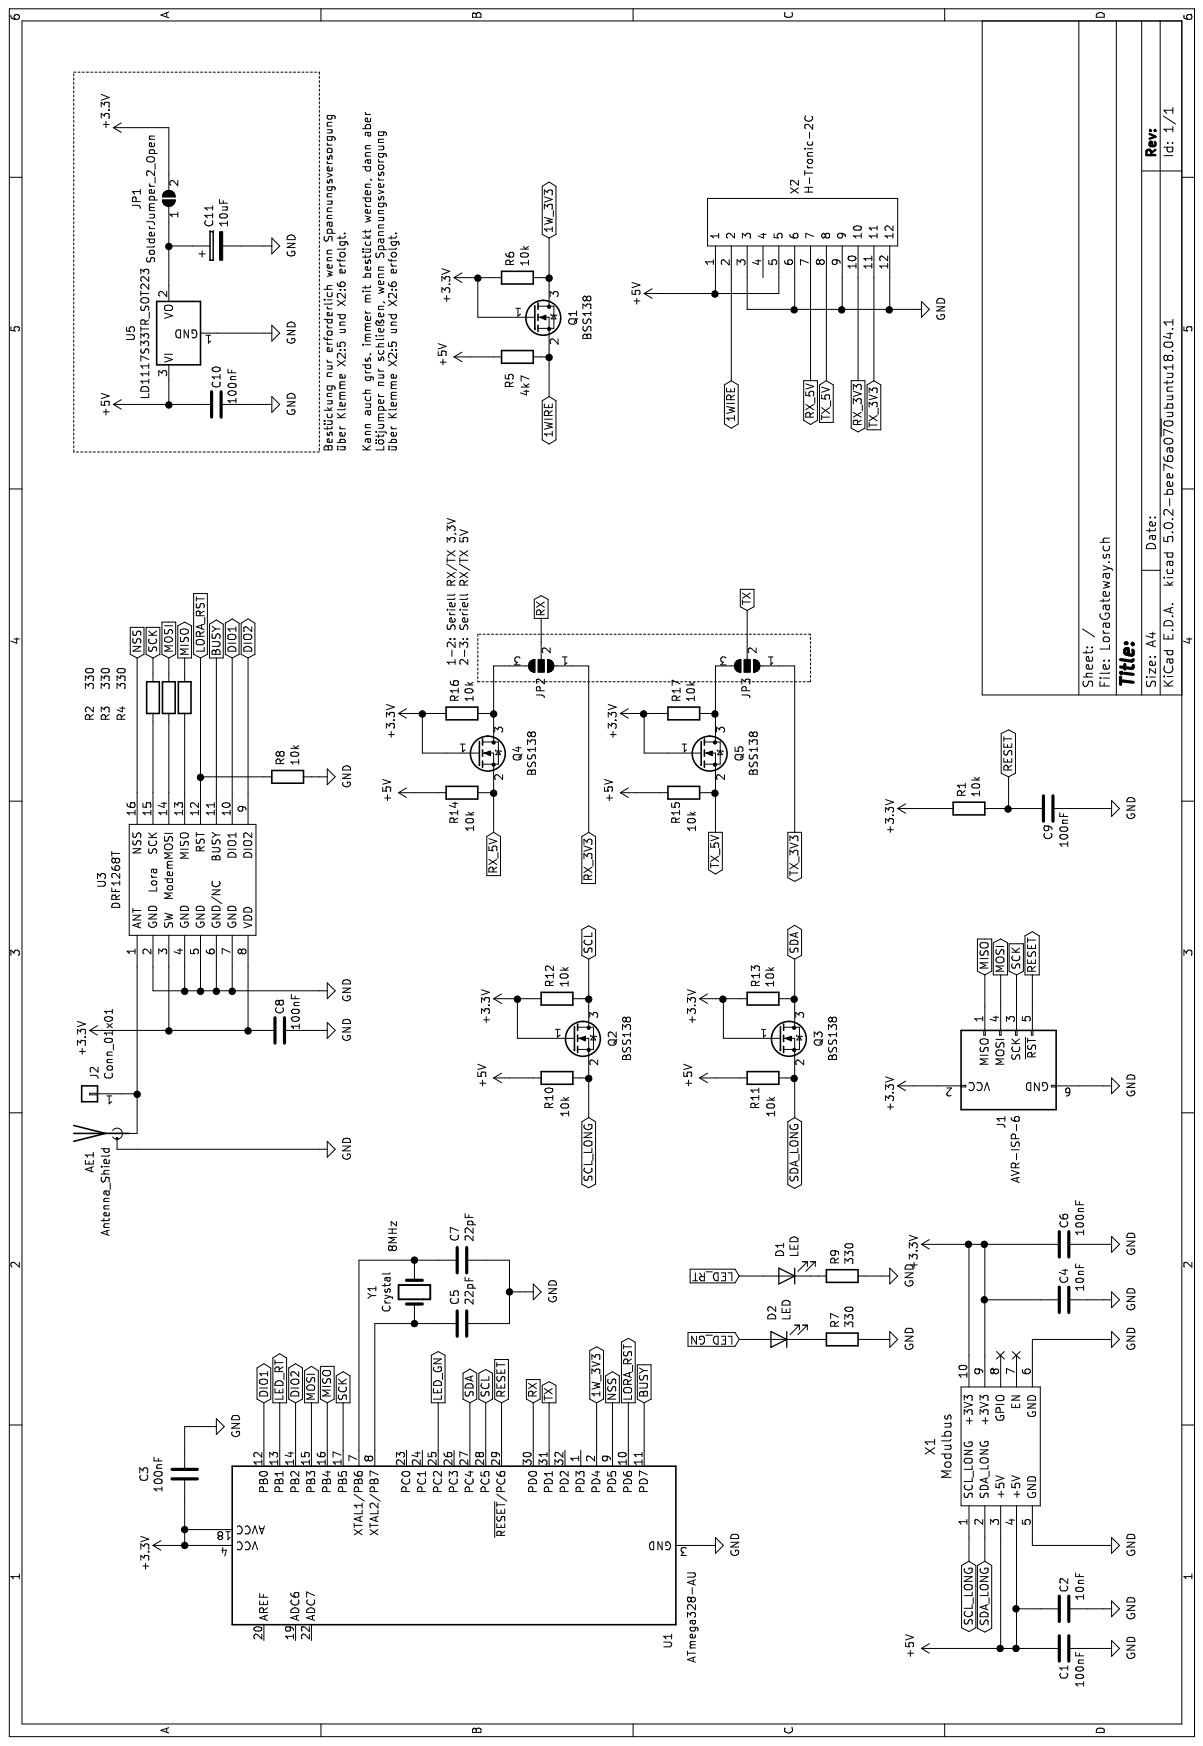
[picture p28: page 1]
