tinytronix/homeautomation/Hardware/Schaltmodul_B/Schematic.pdf

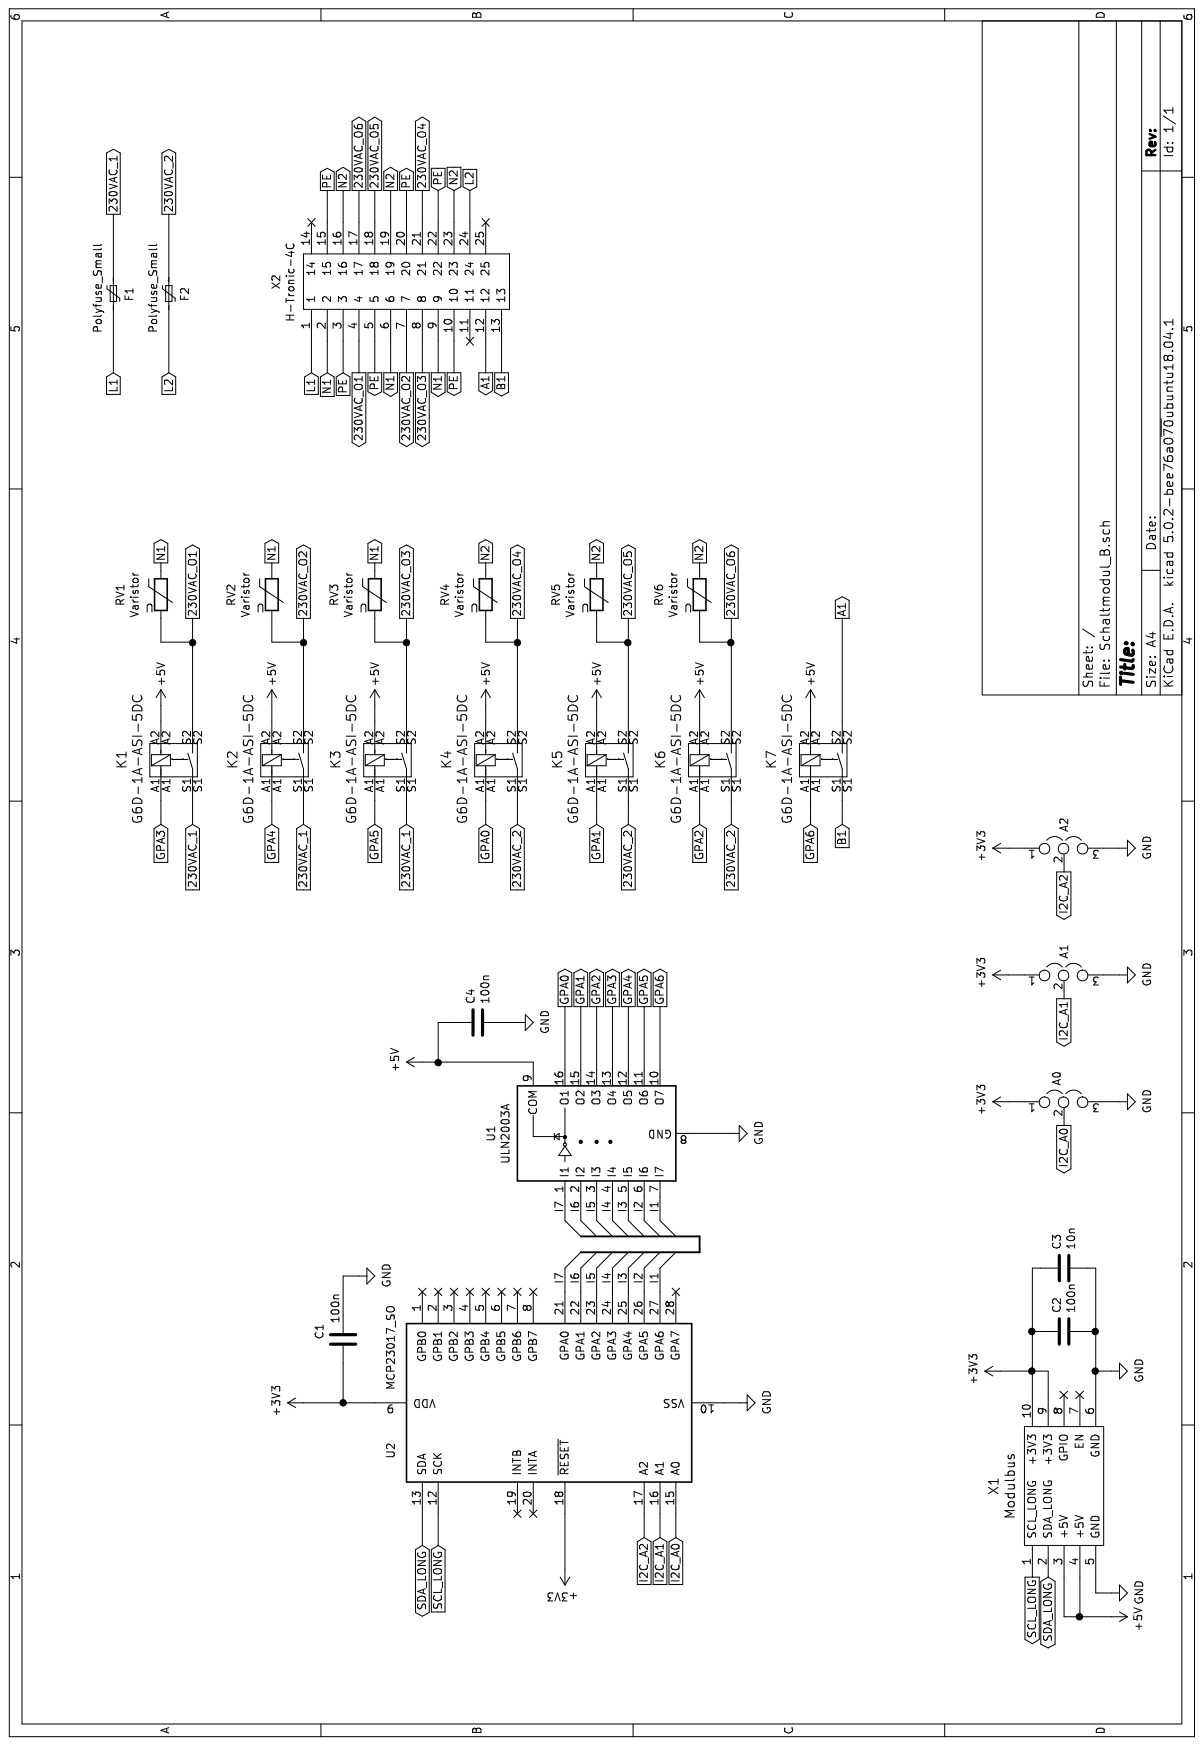
[picture p29: page 1]
