tinytronix/homeautomation/Hardware/Schaltmodul_A/Schematic.pdf

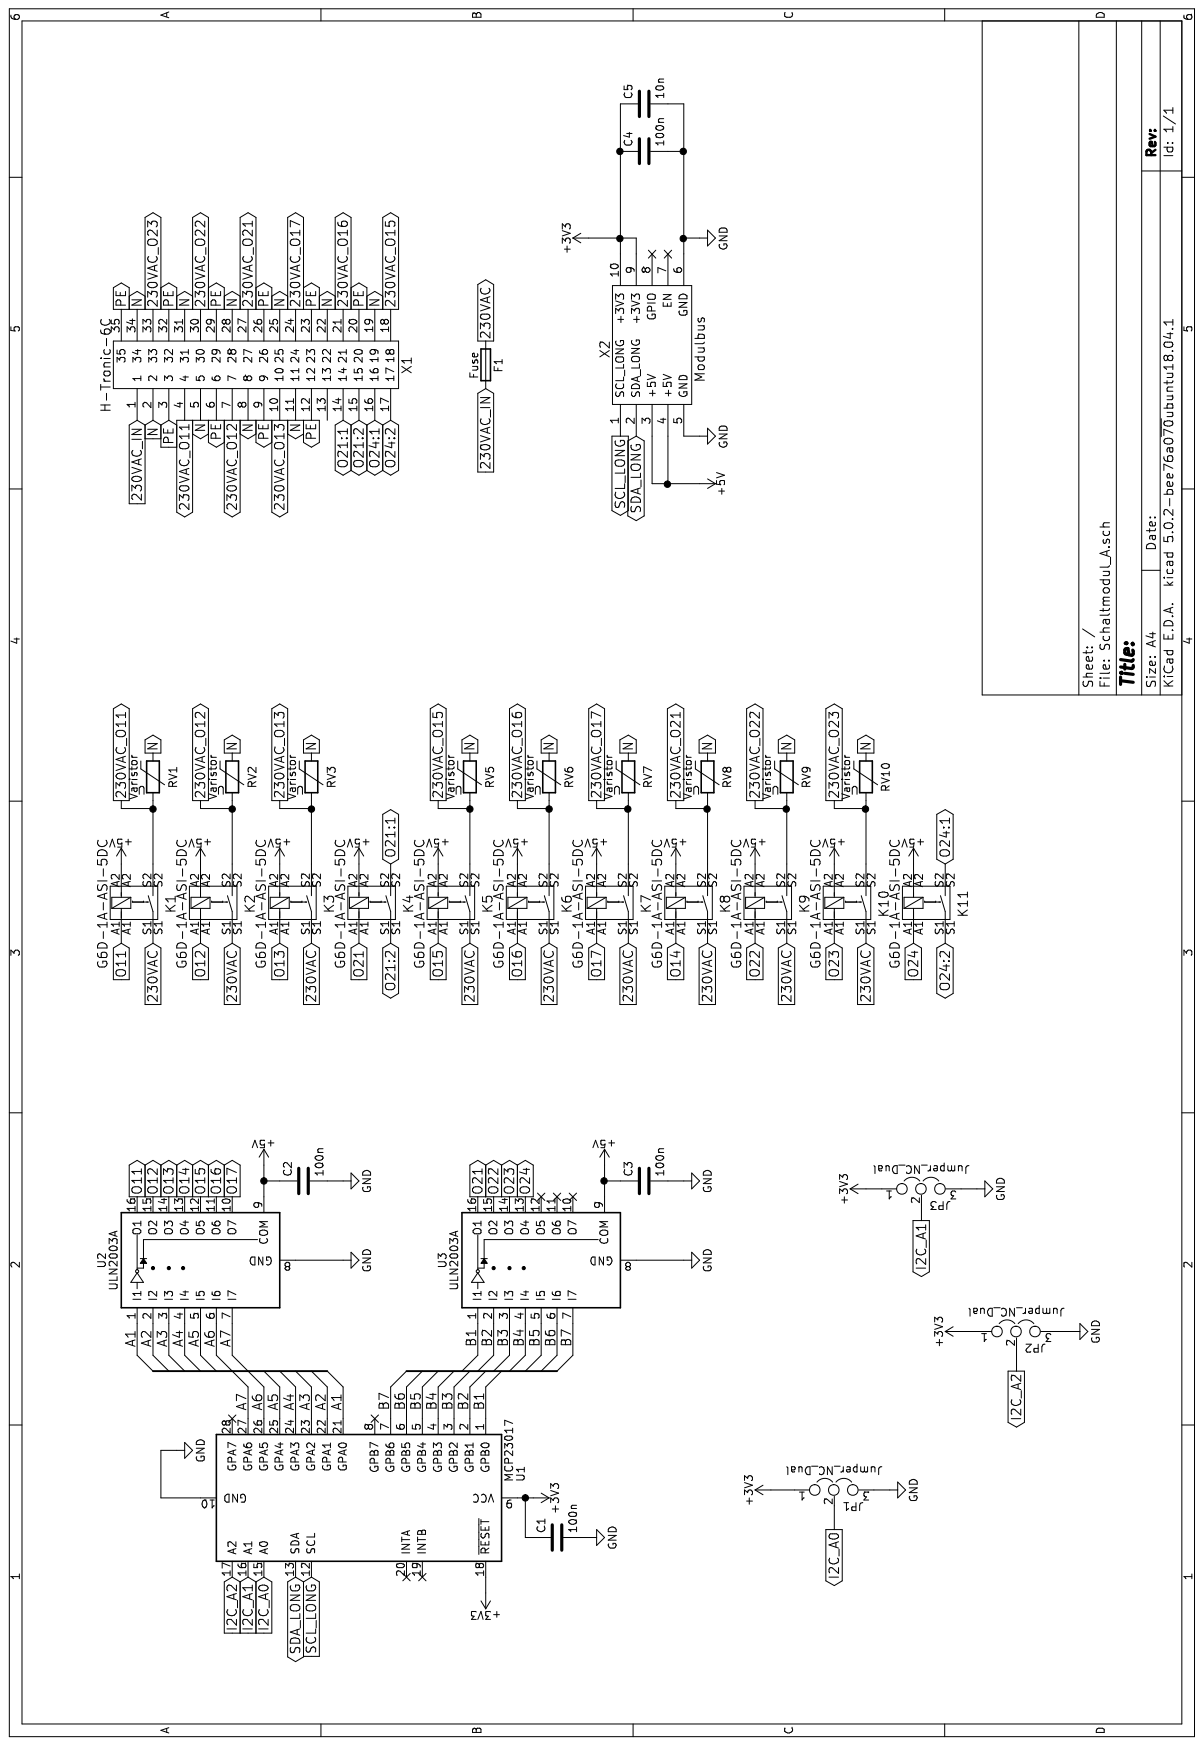
[picture p30: page 1]
