tinytronix/homeautomation/Hardware/Modulbus/Schematic.pdf

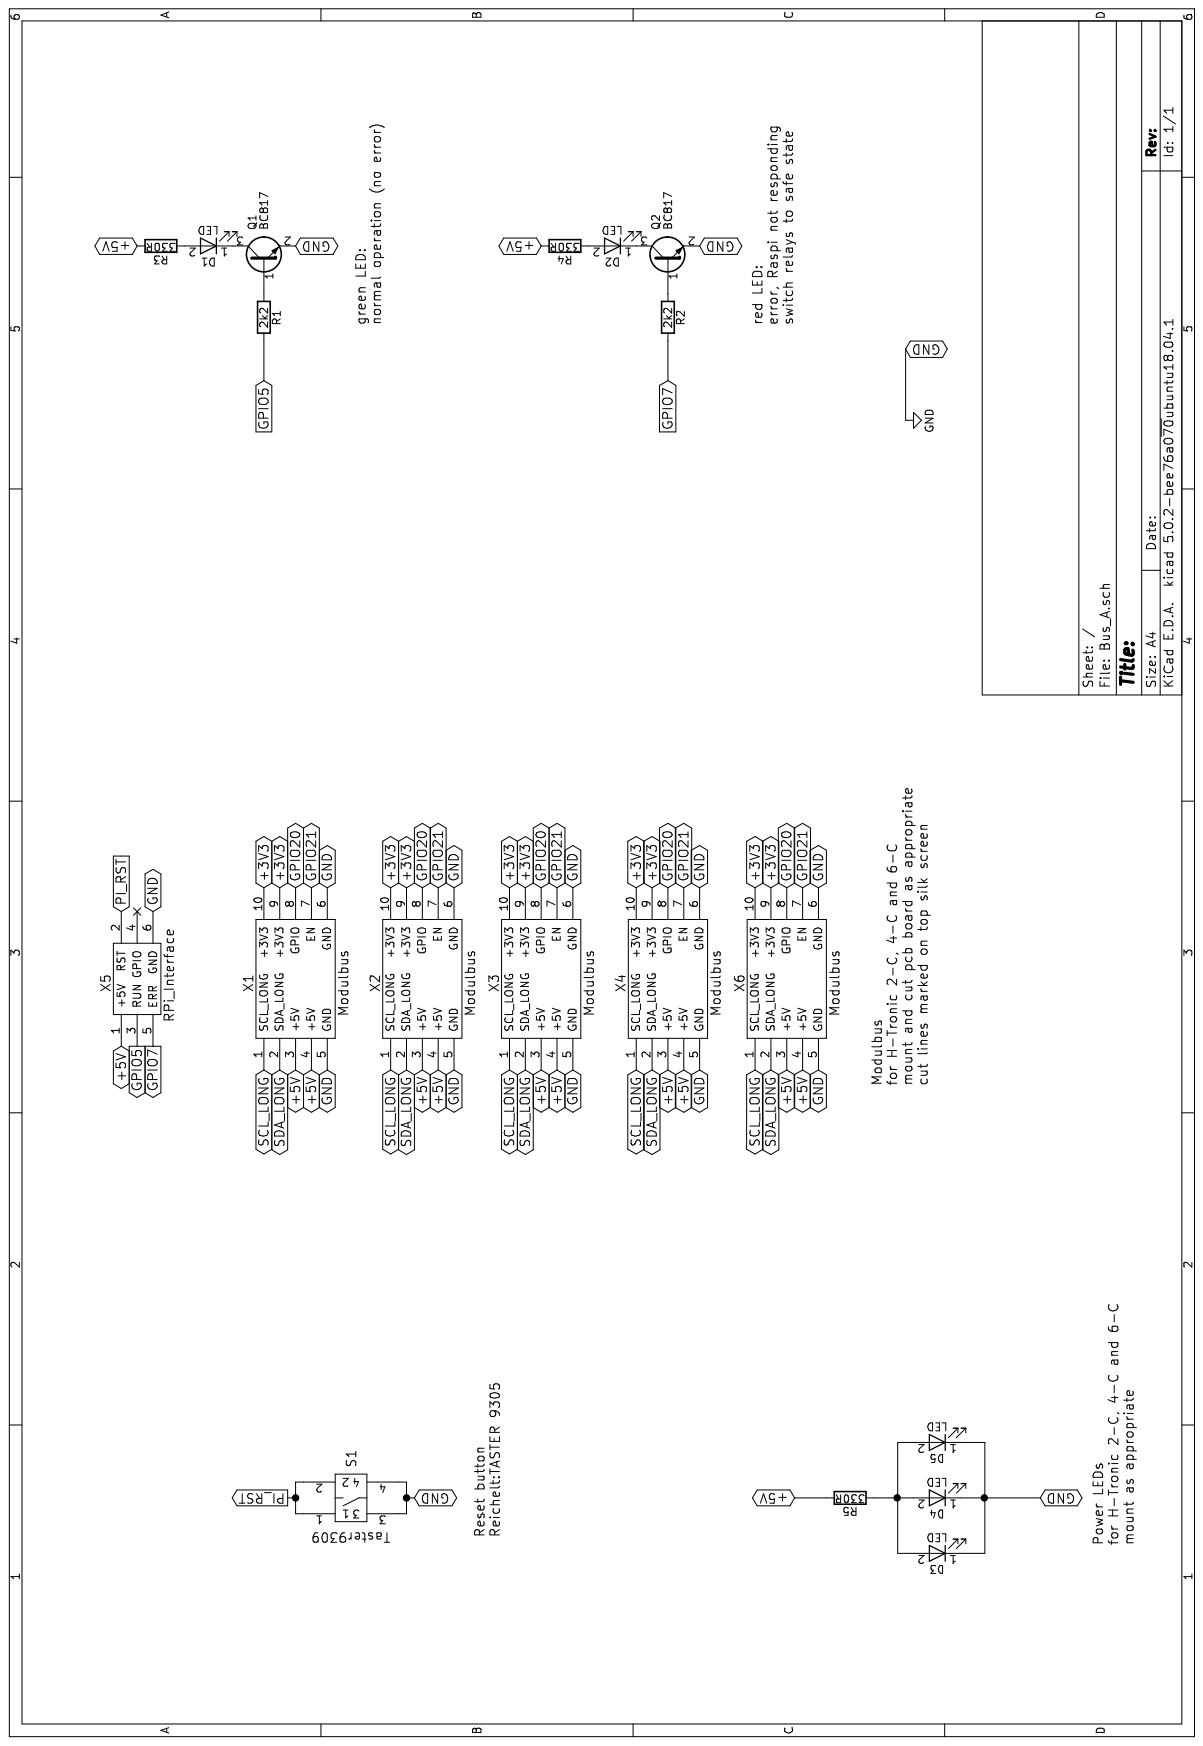
[picture p31: page 1]
