tinytronix/homeautomation/Hardware/Analogmodul_A/Schematic.pdf

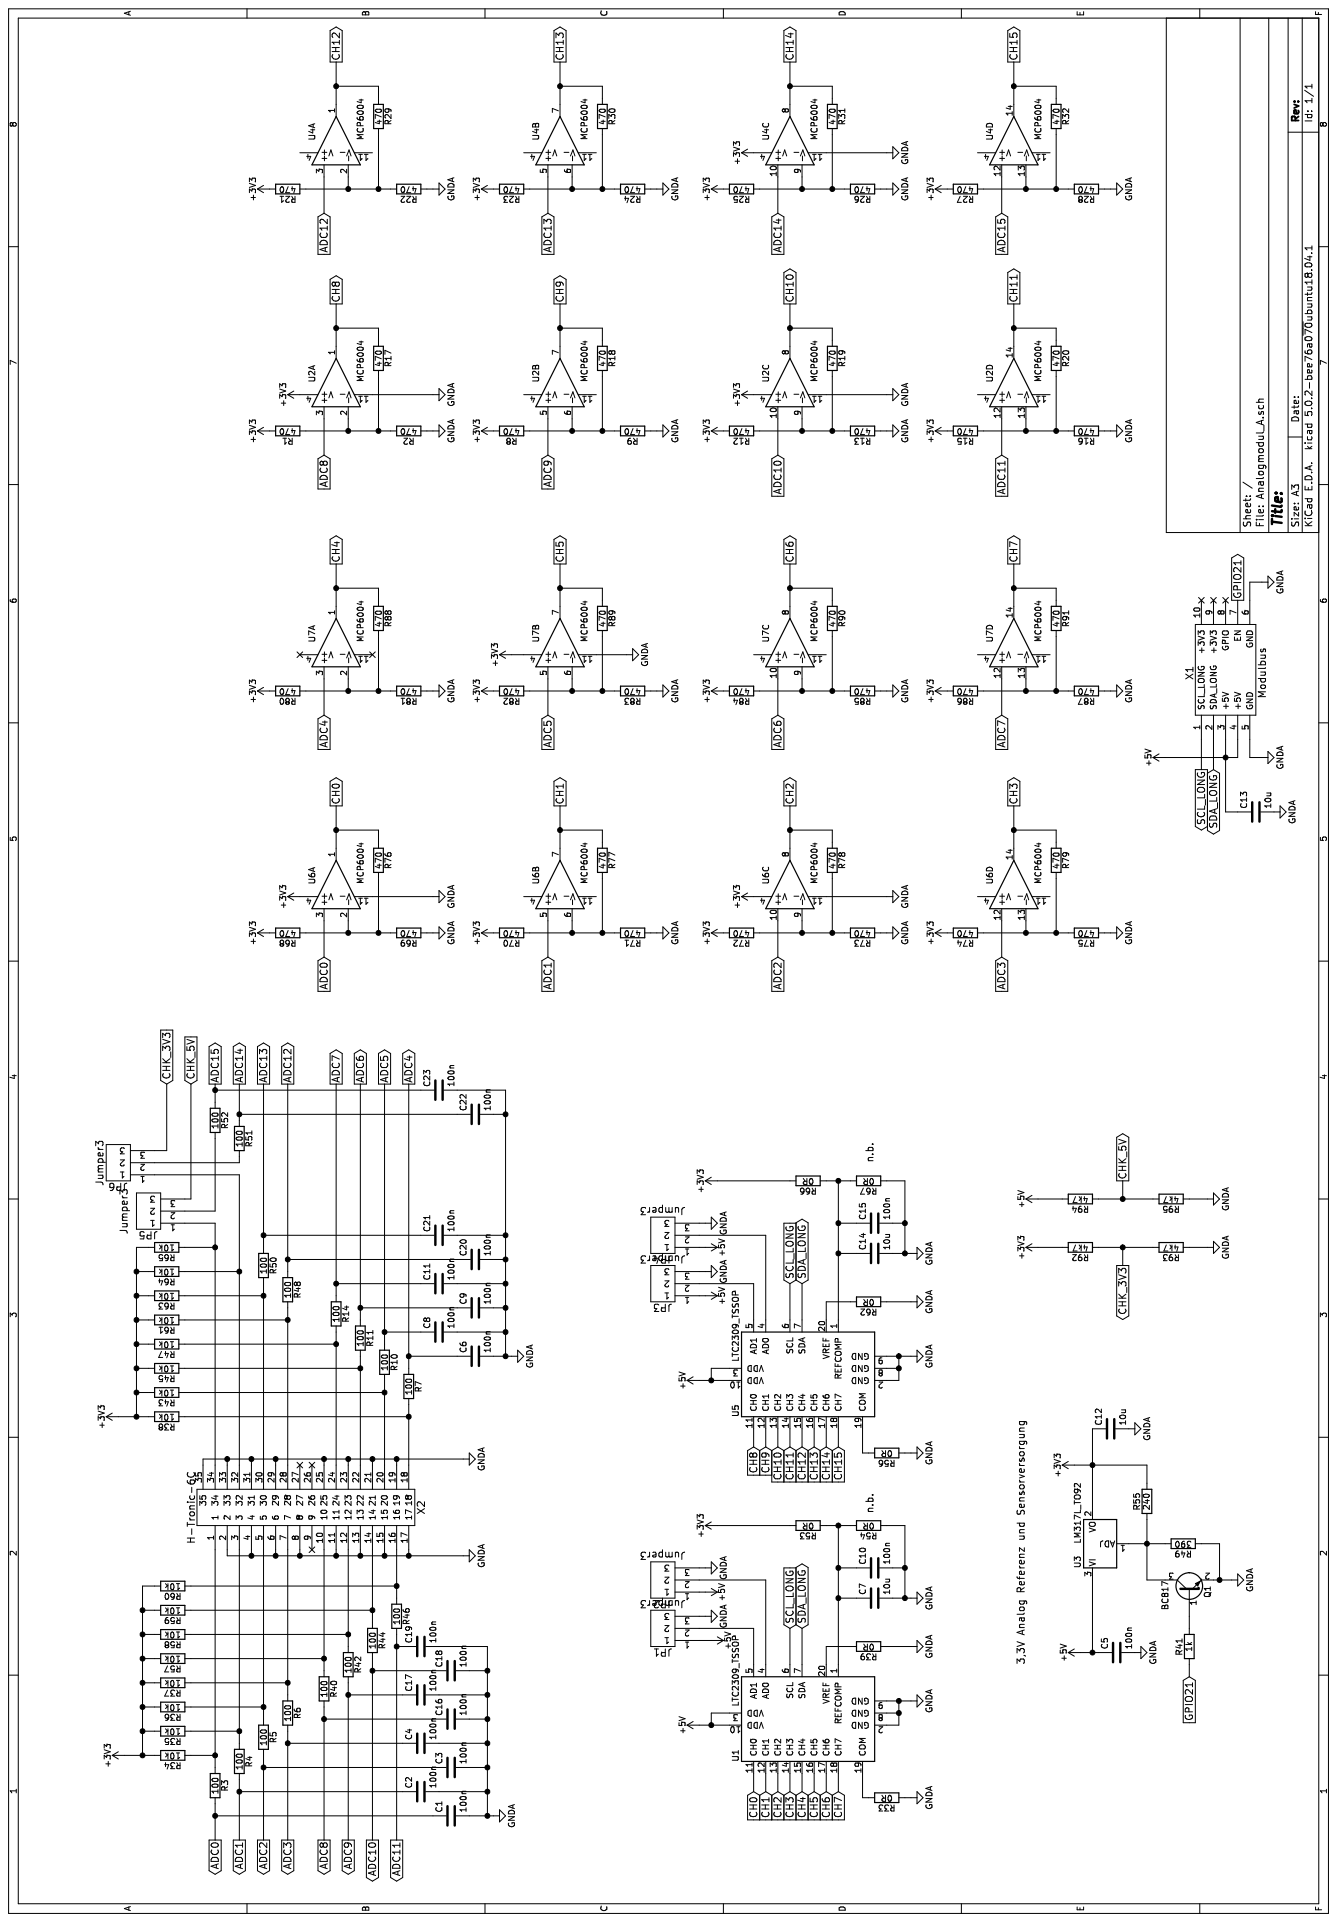
[picture p32: page 1]
