tinytronix/homeautomation/Hardware/Controllermodul_A/Schematic.pdf

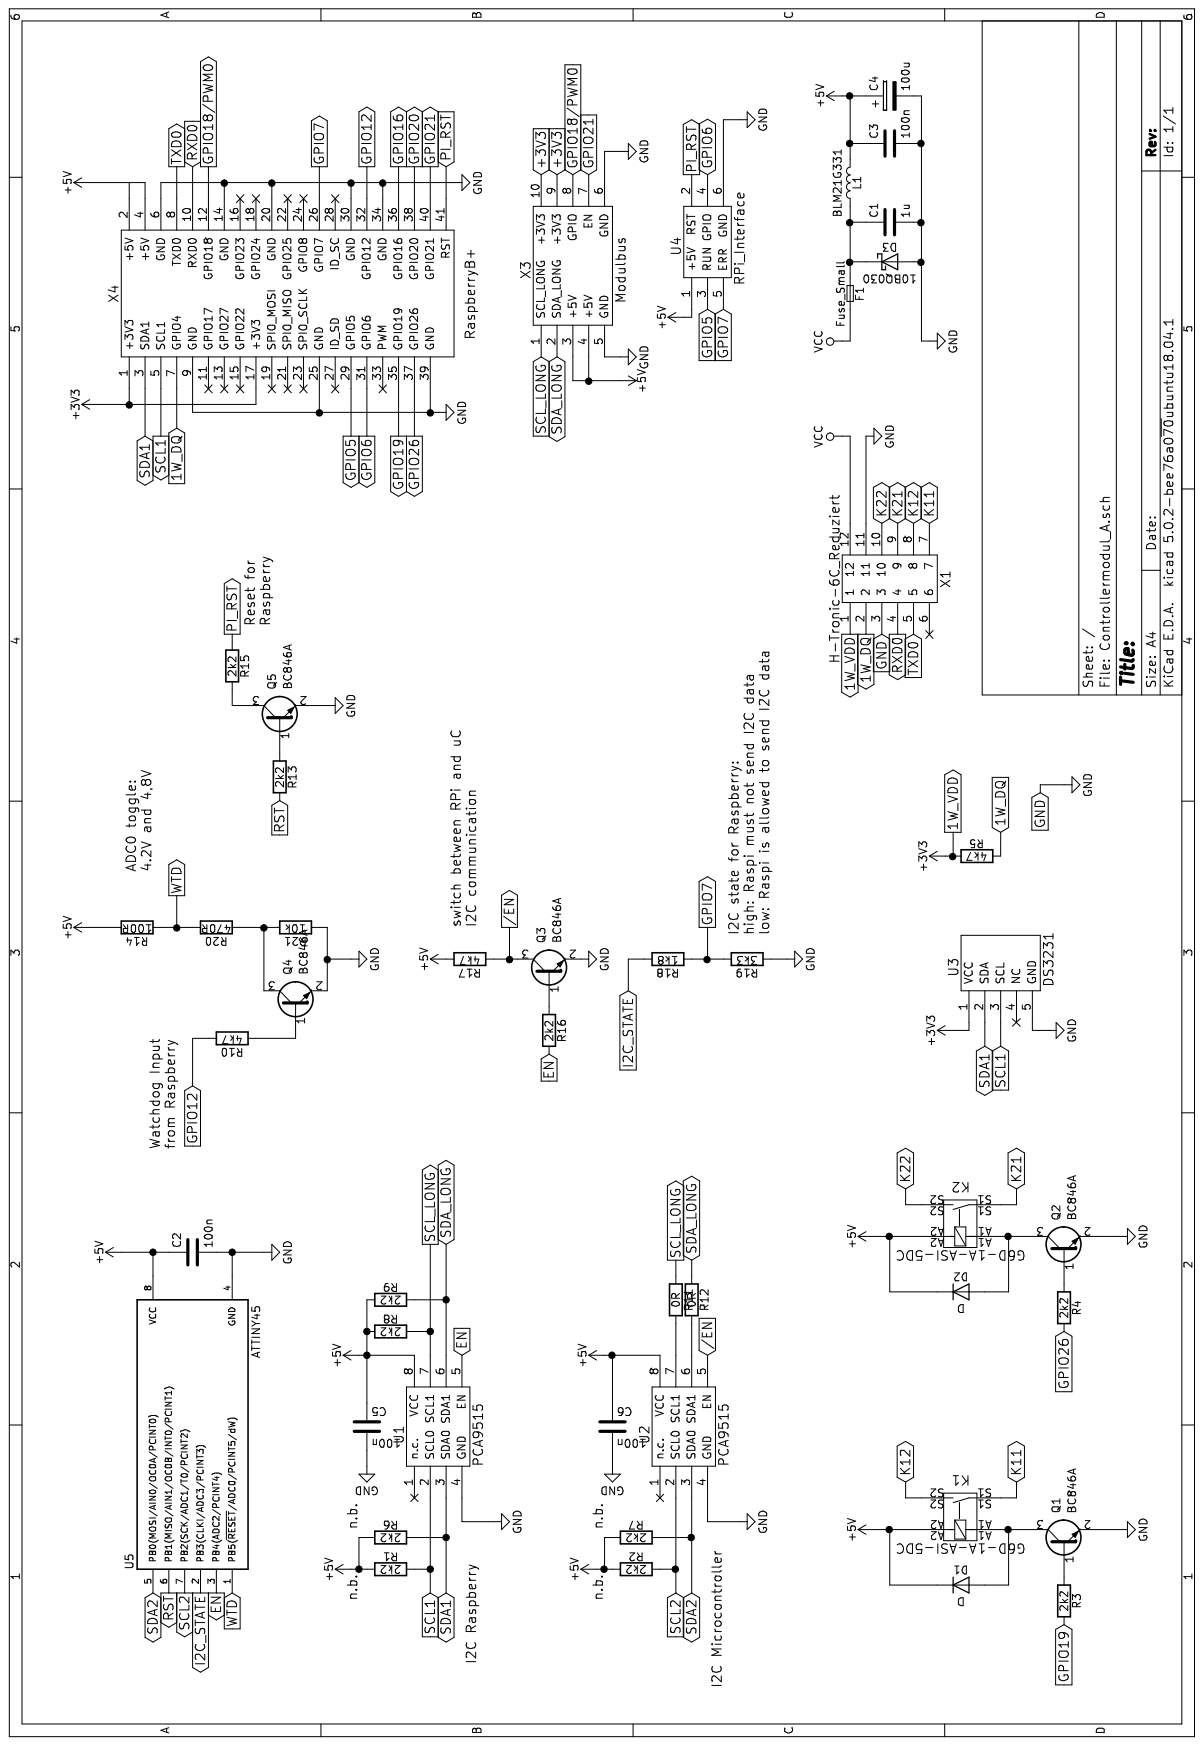
[picture p33: page 1]
