tinytronix/homeautomation/(commit log)

2019-06-09 removed SW pin
2019-07-01 UDP Server for interfacing to DIN Rail Modules
2019-07-09 Example: read sensor and map ADC value to temperature
2019-07-09 Example: using actors and sensors
2019-09-02 added parts for loraInwallShutter and loraPowerSwitch
    [partlist.csv]
2020-06-26 Corrected MCP23017 footprint added slots for better voltage separation
